danyial/makera-jog-wheel/HARDWARE_CHECKLIST.md

# Hardware checklist

Only the human ticks items here. Firmware development checks none of this by itself.

## Hardware checks

- [ ] H-1: Confirm the mapping "silkscreen label → GPIO" for all pins from SPEC 7.3 with the diagnostics screen (10.3), before soldering.
- [ ] H-2: Check whether the axis buttons are normally open (both green wires). If normally closed, switch `BUTTON_ACTIVE_LOW` in `core_config.h` and increase the pull-ups on X and Y to 100 kΩ.
- [ ] H-3: Run one button LED directly from 3V3, measure the current and judge the brightness. Up to 12 mA directly on the GPIO; above that AO3401 high-side and `LED_ACTIVE_HIGH = false`. Too dim: `LED_DUTY_PERCENT = 100`.
- [ ] H-4: In the diagnostics screen, exactly one revolution clockwise: counter +400, one detent = 4 counts. Otherwise adjust `COUNTS_PER_DETENT` or `ENC_INVERT` and record it in `DECISIONS.md`. Additionally turn briskly: no lost detents at 3.3 V (otherwise fallback 5 V + BSS138, SPEC 7.2).
- [ ] H-5: Measure the quiescent current after battery shutdown, target under 1 mA.
- [ ] H-6: Confirm the battery divider 1 MΩ/1 MΩ on GPIO34 on the FireBeetle 2 ESP32-UE (diagnostics screen shows mV). If it is missing, add an external 1M/1M divider with 100 nF.
- [ ] H-7: On USB without a battery in J1, read the voltage in the diagnostics screen. It must lie outside 2800–4400 mV or above 3400 mV; otherwise adjust the thresholds and record them in `DECISIONS.md`.
- [ ] H-8: Read the wheel's current at 3.3 V on the bench supply and enter it in `WIRING.md`. Switch the handwheel on ten times at about 3.5 V battery voltage: no reset. Otherwise soft start at the gate (10 kΩ in series, 100 nF gate–source).
- [ ] H-9: On USB with the on/off button off the board sleeps (display dark, no Wi-Fi), with the button on it runs; with the button off the battery charges (record in `WIRING.md`, details H-23 a, b).
- [ ] H-10: Rotary axis A (ticket #14) with the rotary module connected: (a) The status report contains the 4th value in degrees (serial or display). (b) In inch mode (`G20`) the A value stays in degrees, display unchanged. (c) Capture the status report **without** the module (does it still have 5 values?) and check via MDI in Studio what a small `$J A0.010 F0.500` does without the module; result in `DECISIONS.md`. Until then, enable axis A only with the module connected. (d) Confirm pins GPIO36 (A0, button A) and GPIO4 (D12, LED A) in the diagnostics screen (like H-1).
- [ ] H-11: Carrier board (ticket #20) before milling: check the row spacing of the FireBeetle pin headers on the printout (22.50 mm according to DFRobot footprint DFR0654; if different, change `ROW` in `hardware/generate_board.py` and run `hardware/export.sh`). Print `fab/handrad-1to1.pdf` at 100 %, lay the FireBeetle with its socket headers and JST-XH on it: the holes must match. Before inserting the FireBeetle, use the continuity tester on the FireBeetle itself to check that pin 2 of the top row (3V3) and pin 2 of the bottom row (silkscreen RST/3V3/NC/GND: 3V3) are connected. If the bottom pin 2 is VCC/5 V, do not use the board: 5 V would reach GPIO23/19 via the encoder pull-ups. Since ticket #25 the board is in landscape format: the USB-C socket must protrude 1 mm beyond the left edge. Pogo pins P1/P2 (pitch 3.81 mm): check their position on the printout against the pads "Li-ion −/+" on the FireBeetle underside, measure the gap carrier board ↔ FireBeetle underside; solder in P50-J1 with the head at gap + 1.3 mm above the board (jig). After assembly, check with the multimeter: no connection 3V3–GND and BAT+–BAT−; P2 has contact to "Li-ion +", P1 to "Li-ion −"; the PH2.0 socket on the FireBeetle stays empty.
- [ ] H-12: Web UI (ticket #17) in normal operation, machine online: (a) Status page reachable at `http://handrad.local/` and at the IP reported over serial (`Web: http://…`); values (connection, RSSI, state, WPos/MPos, lock reason, axis, battery, statistics) update about every second and match the display. (b) Save `/settings` without or with a wrong handwheel password: rejected ("Handrad-Passwort falsch" (handwheel password wrong)), nothing changed, no restart; a second attempt within 2 s reports "Zu viele Versuche" (too many attempts). (c) Select axis X, then save with the correct password: rejected with 409 ("Nicht gespeichert: Eine Achse ist gewählt …" (not saved: an axis is selected …)), nothing changed, no restart. Likewise while turning (session active). (d) No axis selected, correct password, e.g. port unchanged and toggle "Drehachse A" (rotary axis A): "Gespeichert" (saved), restart, the change is active. (e) While the status page is open, the machine never moves without turning the wheel.
- [ ] H-13: Loop duration before/after (ticket #17): With the state before #17 (`main` before the merge) and with #17, jog online for 1 min each and note the serial statistics lines (`max. Loop`, `Loop Mittel` (loop average), from #17 also `max. Web`); with #17 once without and once with the status page open in the browser. Expectation: `max. Web` under 5000 µs, `max. Loop` with the status page open at most about 5 ms above the value without, no additional `Keine Daten` (no data) stalls. Result in `DECISIONS.md`.
- [ ] H-14: Screensaver (ticket #28) in normal operation, machine online, no axis selected, serial monitor running: (a) 60 s without button and wheel: the screensaver image appears (serial `Anzeige: Bildschirmschoner` (display: screensaver)) and jumps to a new spot about every 5 s, otherwise the screen is black; the image is recognisable (with `src/logo_bitmap.h`, i.e. the private repository, the Makera "M", without it (public export) the lettering "MPG", tickets #45, #50). (b) 10 min without input: display fully off (`Anzeige: aus` (display: off)). (c) In the screensaver and in the off state, press X once each: the display shows the main screen, **no** axis selected (LED X stays off, `Anzeige: geweckt, Eingabe verworfen` (display: woken, input discarded), no line `Achse: X` (axis: X)). Waking with X and Y almost simultaneously: likewise no axis. A second press on X (later than 0.15 s after waking) selects X. (d) In the screensaver and in the off state, turn the wheel one detent and briskly several detents: the display wakes up, the machine does not move; then select X and turn one detent: exactly one step, no catch-up travel from the wake-up turn. (e) Select axis X and do not operate for 60 s: only when LED X goes out (auto-deselect) does the screensaver start, never with an axis selected. (f) In the screensaver, disconnect the machine's Wi-Fi or switch the machine off: the display wakes up and shows `WLAN…` (Wi-Fi…)/`Maschine…` (machine…) without a button press. In the screensaver, trigger an alarm on the machine (e.g. limit switch by hand): the display wakes up. Only lightly nudge the wheel in the screensaver, without a detent: the screensaver usually stays; half a detent wakes it. (g) Without a display connected (serial only) everything runs as before, the `Anzeige:` lines appear. (h) After a few hours of operation with the screensaver, no visible burn-in of the main screen.
- [ ] H-15: Enclosure (ticket #30), test print: (a) Axis buttons M12, latching on/off button M12 (right wall) and handwheel (cutout Ø 43, 3 × M3 studs, pot 6.4 deep; seating surface flat after removing the supports) fit without rework, button heads sit in their 1 mm pockets, the handwheel flange sits just below the front, the handwheel strands can be bent behind the body and routed along the intended path (up in front of the battery, over the battery between Y and Z) to J6; the buttons' nuts can be tightened next to each other. (b) Display: glass rests against the window, visible area complete, module sits on the 4 pins without pressure on the glass. (c) With the enclosure closed, plug the USB-C cable fully into the FireBeetle's socket: charging and serial work. (d) Lip/rebate close without gaps, 4 × M3 × 10 engage in the heat-set inserts. (e) PCB adhesive antenna 50 × 15 (ticket #44) in the recess on the top end wall, excess cable as a loop in front of the FireBeetle, does not get pinched when closing: measure RSSI (web UI or serial) at the same spot once with the board open (antenna free) and once in the closed enclosure, record the difference and values in `DECISIONS.md`. Connection in the closed enclosure stable at the usual location (no `WLAN…` interruptions over 10 min). (f) Insert the battery with hook-and-loop tape, the tray lies flat.
- [ ] H-16: Feed from turning speed and bundling (ticket #32), machine online, axis X, serial monitor running: (a) Turn slowly detent by detent: exactly 0.01 mm per detent, immediate response, no motion without turning. (b) Turn evenly at medium speed (about 1 revolution in 2 s): the machine moves evenly, `Begrenzt` (limited) does not appear or only very briefly. (c) Turn evenly fast (about 2 revolutions per second): no more heavy stop-and-go as before #32; note the impression (smooth / slight jerking / heavy). (d) Measure the overrun after letting go with a stopwatch or the position display. Expectation (SPEC 8.7): distance about `0.08 × turned distance + 0.11 s × speed`, at most 5 mm; time about `0.09 × turning duration + 0.2 s`. Examples: 2 s medium (about 5 mm/s) → about 1.6 mm in 0.4 s; 10 s slow (about 1 mm/s) → about 1 mm in 1.1 s; long fast → 5 mm in about 0.3 s. Never more than 5 mm. (e) The same with XY (diagonal, same feel as X) and Z (overrun at most 1 mm, Z never faster than 5 mm/s). (f) With axis A and rotary module (if available), turn at medium speed: no error, overrun at most 2°; A may still stutter somewhat (the firmware accelerates A itself). (g) Turn quickly back and forth: after letting go, no overrun beyond the window. (h) Turn slow-to-medium for 30 s without pause, then let go: no error message, no position error (end position = display), overrun at most 5 mm (upper limit of the queue). (i) A/B comparison: flash (b), (c) and (d) once with `FEED_LEAD_PCT = 92` (state of the ticket) and once with `FEED_LEAD_PCT = 130` in `core_config.h` and compare (jerking, `Begrenzt`, overrun). Result (in particular (c), (d) and (i)) in `DECISIONS.md`; adjustments of `FEED_LEAD_PCT`, `FEED_WINDOW_MS` or `BUNDLE_MS` as a separate ticket. **Addendum ticket #38:** Until now `F` ran with wrong machine rates (X/Y 2.5 times, Z 1.67 times too fast), so the machine moved faster than turned. Results of (a)–(i) before #38 are not valid; after #38 (rates via `M203.1`, H-20) **re-check everything**, in particular (c) stop-and-go, (d) overrun and (e) Z never faster than 5 mm/s.
- [ ] H-17: OTA update over Wi-Fi (ticket #35), handwheel in normal operation, machine online, serial monitor running (or USB disconnected, then display only): (a) By default or after the first flash of this firmware, "Update über WLAN erlauben" (allow update over Wi-Fi) is off in the portal and under `/settings`; `HANDRAD_OTA_PASS=<Handrad-Passwort> pio run -e firebeetle-ota -t upload` fails (no response), no `OTA:` line on serial. (b) Enable the checkbox, save, restart; serial `OTA: erlaubt, espota an handrad.local Port 3232 …` (OTA: allowed, espota to handrad.local port 3232 …). The status page and `handrad.local` keep working fine (mDNS not disturbed). (c) No axis selected: upload with wrong password → espota reports "Authentication Failed" (the automatic MD5 second attempt gets no response because of the lockout), serial once `OTA: abgelehnt (Passwort falsch)` (OTA: rejected (password wrong)) and `OTA: nach falschem Passwort 5000 ms gesperrt` (OTA: locked for 5000 ms after wrong password); a new upload within 5 s gets no response, afterwards it does again, no restart, the connection to the machine remains (note the duration of the check from `OTA: handle() dauerte … ms` (OTA: handle() took … ms); above about 2500 ms → `Keine Daten`/connection teardown possible, then result in `DECISIONS.md`). (d) With the correct password: display "Update" with a rising percentage, serial `OTA: Update startet …` (OTA: update starting …) and `OTA: … %`, then "Fertig, Neustart" (done, restarting), the new firmware runs (e.g. start screen, uptime on the status page reset), Studio and Home Assistant stay connected. Also from the screensaver or with the display switched off: the display turns on for the update. (e) Select axis X (LED on), then start the upload: espota aborts without a response ("No response from the ESP"), the handwheel stays in operation, X stays selected, **the machine does not move**. Likewise while turning. Then deselect X: the upload works on the next attempt. (f) Start the upload and at about 50 % disconnect the computer's Wi-Fi or abort espota with Ctrl-C: after at most a few seconds "Fehlgeschlagen" (failed), restart, the **old** firmware runs (check version/uptime), the connection to the machine comes back. (g) Never any machine motion during an upload; after the restart no axis is selected.
- [ ] H-18: New web UI (ticket #36) on the device, machine online, phone (portrait and landscape) and desktop browser, light and dark: (a) Status page, `/settings` and the captive portal look the same and load without internet (airplane mode with only the handwheel/workshop Wi-Fi); all fields in the portal and under `/settings` incl. "Update über WLAN erlauben" and "Handrad-Passwort" (handwheel password) save as before. (b) State, lock reason, WPos/MPos and battery match the display; when jogging with the wheel the crosshair glides without jumps, the numbers show the real value, the selected axis is highlighted. (c) Switch the handwheel off: after about 3 s, "Keine Verbindung zum Handrad" (no connection to the handwheel) appears in red at the top. (d) **Check the spoilboard position** (measured in ticket #40, corner −206.580/−209.140 mm MPos): use the handwheel to move the tool exactly over the centre of one hole at the back right and one at the front left (30.0/7.5 mm from the front left corner); the map's crosshair sits centred on the hole in each case, below the map there is no notice "Plattenlage geschätzt" (spoilboard position estimated). If there is a deviation, note MPos X/Y of the hole and report it (if only one is off, the spoilboard is rotated/mirrored). (e) Repeat H-12 and H-13 (loop duration, `max. Web`) with the new status page open and note the results. (f) Weak Wi-Fi: phone or laptop at the farthest point of the workshop (handwheel RSSI about −80 dBm, shown on the status page under connection → Wi-Fi), reload the status page several times: it loads completely every time (position map and numbers present), and the serial log shows no `Web: Anfrage verworfen (Zeitlimit beim Senden …)` (web: request discarded (timeout while sending …)) (the roughly 12 KB must go out within `WEB_REQ_TIMEOUT_MS = 2000`).
- [ ] H-19: 3D view (ticket #37) on the device, machine online, serial monitor running: (a) Open the status page on the phone (workshop Wi-Fi, without internet) and on the desktop: it appears immediately in 2D as before. Tap "3D": time until the image appears (first load, about 178 KB) and note it; on the second opening 3D comes from the browser cache (almost immediately). Meanwhile the status polling keeps running (no red bar "Keine Verbindung" (no connection) for longer than briefly). (b) Loop duration as in H-13: note the serial statistics line (`max. Loop`, `Loop Mittel`, `max. Web`) once without a browser and once during the first load of the 3D view (clear the browser cache beforehand, two devices at the same time); expectation `max. Web` under 5000 µs, no additional `Keine Daten` stalls, no `Zeitlimit beim Senden` (timeout while sending) on serial. With an axis selected and the wheel turned: the machine moves as it does without a browser. (c) In 3D: rotate, zoom, pan with finger and mouse; "Ansicht zurücksetzen" (reset view); when jogging with the wheel the tool glides without jumps, position and work zero match the 2D map, the travel trail shows the path. Toggle light/dark. Reload the page: 3D stays selected. (d) With the rotary axis module connected and "Drehachse A vorhanden" (rotary axis A present): the module appears, the stock rotates with A, the angle matches the display; the position of the module is checked in H-22 (ticket #48). (e) After an OTA update (H-17) with a changed 3D view, the new version arrives (new path `/a/v3d-…`) without clearing the cache. Result (load time, loop values) in `DECISIONS.md`. (f) Ticket #39, rotary axis module connected or not: in the settings, "Drehachse A vorhanden" off: the status page shows no line A under position, no A disc in 2D, in 3D neither module nor angle chip nor the "A-Modul" (A module) switch (even if the machine reports an A value). Switch on and save: everything appears again, the chip shows the work angle large and the machine angle small, matching line A. (g) With rotary axis: switch "A-Modul" off → the module disappears, the chip remains; reload the page → stays off; on again → module is there. On the desktop (from 900 px) the position map is wider than the right column, the right cards stack without gaps.
- [ ] H-20: Maximum rates at runtime (ticket #38), machine online, serial monitor running: (a) After switching on, shortly after `Link: Online` exactly one line `Raten: X 50.000 Y 50.000 Z 16.667 mm/s, A 30.000 Grad/s (M203.1)` (rates: … degrees/s) appears (the machine's values; on the user's Z1 Pro `M203.1` reports A = 30 °/s, A possibly `unbekannt` (unknown)); if instead `Raten: Antwort verworfen: …` (rates: answer discarded: …) appears, note the line and record it in `DECISIONS.md` (parser ticket, do not bypass the lock). (b) Select axis X immediately after switching on and turn: until the rates are in, display and web UI show `Raten unbekannt` (rates unknown), the machine does not move; then `Bereit` (ready), jogging works. (c) Watch the console in Studio: the answer to `M203.1` and `ok` appear there once per connect, Studio stays connected and works normally. (d) Switch on with the machine in alarm (e.g. emergency stop pressed): display `Alarm` with the real alarm line (never `error:Alarm lock`), on serial **no** `Raten:` line and no `Maschine meldet: error:Alarm lock` (machine reports: error:Alarm lock) as long as the alarm persists; after acknowledging the alarm immediately (under 1 s) `Raten: …` and jogging possible. (e) Without an answer (e.g. machine busy during connecting): the connection stays up (no teardown because of the query), serial retries after 1 s, 2 s, 5 s, 5 s. (f) Switch the handwheel off and on, or briefly disconnect the machine's Wi-Fi: the rates are re-read on every connect (new `Raten:` line). (f2) Re-read: handwheel connected, no axis selected, machine Idle; watch the console in Studio: about every 30 s an `M203.1` answer with `ok`, Studio works normally; none during a handwheel session (turning) or in alarm. Machine settings are not changed for this; that a changed rate is adopted and that a failed re-read keeps the old rates is checked only by test 99. (g) Then H-16 completely again, with axis X: (c) fast turning without heavy stop-and-go, Z never faster than 5 mm/s, X/Y never faster than 20 mm/s.
- [ ] H-21: Unlock after alarm (ticket #41, SPEC 8.10), machine online, Studio connected, serial monitor running: (a) Put the machine into alarm (halt in Studio/`Ctrl-X`), no axis selected on the handwheel: the display immediately, or after an alarm line that may be shown (2 s), shows `Entsperren: Taste 5 s` (unlock: hold button 5 s) (outside Grbl mode `Ctrl-X` only reports `HALTED, M999 or $X to exit HALT state`, no alarm line), the web UI shows `Alarm, Taste 5 s: Entsperren` (alarm, button 5 s: unlock) in red. (b) Press X and release after about 3 s: the bar runs, serial `Entsperren: abgebrochen (losgelassen)` (unlock: aborted (released)), the machine stays in alarm. (c) Hold X for 5 s: bar full, `Entsperren...` (unlocking...), serial `Entsperren: $X gesendet` (unlock: $X sent), Studio shows `[Caution: Unlocked]`, the machine reports `Idle`; nothing moves, not even after 10 s. (d) In alarm and while holding, turn the wheel vigorously, then unlock: the machine does not move afterwards; only new turning moves it (X is selected). (e) Press the button already before the alarm and keep holding: no unlock; only releasing and a new 5 s hold unlocks. (f) Alarm with the display asleep (screensaver): the display wakes up by itself, after that the first press counts. If it falls asleep again during the persisting alarm, the first press only wakes it (serial `Anzeige: geweckt, Eingabe verworfen`), holding does not unlock; only a new press does. (g) After `$X`, compare the reported position with Studio (equal); the rates remain known. (h) Limit switch alarm (carefully drive slowly into a limit switch): unlock works the same way, moving away from the limit switch works, moving further into it triggers alarm again. (i) With Studio connected, observe whether the notice stays visible: if the Wi-Fi module mirrors error lines of other clients (`error…`), they displace it for 2 s and abort a running hold (serial `Entsperren: abgebrochen (neue Meldung)` (unlock: aborted (new message))); note how often that happens. (j) Each of the buttons X, Y and Z triggers individually (bit mapping). With `axis_a` disabled, hold button A for 5 s → no unlock; with `axis_a` enabled, A unlocks too. (k) Short Wi-Fi hiccups while holding (e.g. handwheel further away from the AP) do not abort (no `Entsperren: abgebrochen` on serial); sending happens with the next fresh status.
- [ ] H-22: Position of the rotary axis module from CAD (ticket #48, SPEC 9.1, DECISIONS.md 2026-11-11), Makera rotary module mounted as intended by Makera, "Drehachse A vorhanden" on, machine online, 3D view open. Jog carefully with the handwheel (slow, no stock in the chuck or a known round stock), never touch the module with a running spindle. Note MPos values and report them: (a) **Axis Y:** bring the tool tip (pointed tool or probe pin) to the centre of the live centre tip of the tailstock (or by eye exactly above the axis on a clamped round stock) and read MPos Y. Expected from CAD: **−115.88 mm**; anchor 1 + `rotation_offset_y` of the machine config would give −125.14 mm. Which one fits (± 1 mm)? (b) **Axis height:** measure from the spoilboard top to the axis (e.g. caliper to the live centre tip): expected **45.0 mm**. (c) **X:** touch the front face of the chuck body (Ø 48.7 mm, behind the jaws) from the right with the side of the tool: expected tool centre MPos X ≈ **−163.34 mm plus the tool radius**; the front faces of the jaws ≈ −149.44 mm, the headstock block (front face −196.34 mm) is hidden behind the chuck. The tailstock can slide on the rail: in CAD its live centre tip is at −16.15 mm, the view always draws it there. (d) In the 3D view the module sits where it sits on the machine (headstock left, motor housing in front of the axis, tailstock right), the stock rotates with A in the same direction as on the machine, the chip shows "Lage der Drehachse aus CAD". `UI_A_POS_CALIBRATED` is only set to true in a follow-up ticket once (a)–(c) fit or are corrected.
- [ ] H-23: Soft power (ticket #49, SPEC 9.3), serial monitor running where possible: (0) Boot line shows `Platine Rev. 2`, the diagnostics screen `Platine 2`; confirm the rev-2 pin map in the diagnostics screen like H-1: buttons X GPIO13, Y GPIO26, Z GPIO35, A GPIO36, LEDs X GPIO14, Y GPIO25, Z GPIO15, A GPIO12, on/off GPIO4; the board boots normally with all LEDs connected (GPIO12/15 are strapping pins). (a) Button off, USB unplugged: current from the battery (multimeter in series at J1) **below 1 mA**; note the value in `WIRING.md`. (b) Button off, USB plugged in, battery not full (record in `WIRING.md`): the FireBeetle's charge LED is on and the battery reaches about 4.2 V (charge LED off), the handwheel stays asleep (display dark). (c) Switch on: the handwheel wakes and starts normally (start screen, Wi-Fi, no axis selected), also on battery only; X held while switching on → portal. (d) Flash over USB with the button off: after the upload the serial monitor shows `Ein/Aus: aus beim Start, Tiefschlaf` and the display stays dark; switching on starts the new firmware. (e) Machine online, select X and turn: switch off during the motion → serial `Ein/Aus: aus, Tiefschlaf`, the motion ends within the window (at most 5 mm), Studio shows no further `$J` from the handwheel, Studio and Home Assistant stay connected; switch on → reconnects, nothing moves until turned again. (f) Battery shutdown (bench supply below 3.3 V) with the button on: "Akku leer – bitte ausschalten", then dark; the handwheel does not restart by itself; button off and on with the supply still low → "Akku leer" again; supply at 3.8 V → off and on starts normally.
  (h) Board revision guard: erase the flash (`pio run -t erase`), flash, serial `Platine Rev. 2 gespeichert` once; the next start without that line.

## Acceptance on the machine (SPEC ch. 13)

- [ ] A-1: Job running in Studio: the handwheel shows `Job läuft` (job running), turning moves nothing.
- [ ] A-2: X alone, XY diagonal and Z alone move in the positive direction when turned clockwise. A press on Z with X selected deselects X and selects Z (the LEDs show it).
- [ ] A-3: 60 s without turning: all axis LEDs go out, turning moves nothing.
- [ ] A-4: Turn the wheel fast for 1 s and let go: the machine stops after at most 5 mm (XY) or 1 mm (Z) overrun (window since ticket #32).
- [ ] A-5: Turn quickly back and forth: after letting go, no overrun beyond the window.
- [ ] A-6: Studio and Home Assistant stay connected while the handwheel is used.
- [ ] A-7: On/off button off while moving (with and without USB): the motion ends within the window, afterwards the machine receives no more commands, the handwheel sleeps (H-23 e).
- [ ] A-8: Switch the handwheel off and on three times within 1 min, each time until "Online": Studio and Home Assistant stay connected, the handwheel reconnects each time. Result in `WIRING.md`.
- [ ] A-9: X held at power-on → web UI. "Diagnose starten" (start diagnostics) → diagnostics screen. Y or Z held at power-on → no axis selected.
- [ ] A-10: Let the battery contact J1 bounce briefly (loose contact) with a full battery: no shutdown. Tap the on/off button contact for under 0.1 s: no sleep.
- [ ] A-11: Battery shutdown (bench supply instead of battery, slowly below 3.3 V): display "Akku leer – bitte ausschalten" (battery empty – please switch off), afterwards quiescent current < 1 mA (H-5).
- [ ] A-12: Battery operation without USB, wheel at 3.3 V: one revolution turned briskly yields exactly 100 detents, even at about 3.5 V battery voltage.
- [ ] A-13: Spindle running: the handwheel shows `Maschine belegt` (machine busy).
- [ ] A-14: Axis A enabled in the portal, rotary module connected: button A deselects and selects A, turning clockwise rotates A in the positive direction, overrun at most 2°. Axis A disabled: button A has no effect, LED A off.
- [ ] A-15: Web UI (ticket #17): status page reachable, saving only with the handwheel password and only with no axis selected, saving restarts and applies the values (H-12).
- [ ] A-16: Screensaver (ticket #28): screensaver after 60 s, display off after 10 min, waking via button or wheel selects no axis and does not move (not even with two buttons), connection loss and alarm wake it (H-14).
- [ ] A-17: Feed (ticket #32): turn evenly at medium and fast speed, the machine moves without heavy stop-and-go, `Begrenzt` does not appear at medium speed (H-16, after ticket #38 with rates read, H-20).
- [ ] A-18: OTA (ticket #35): off by default; when enabled, the update over Wi-Fi works, with an axis selected it is rejected and the machine never moves; an abort in the middle of the upload leaves the old firmware running (H-17).
- [ ] A-19: 3D view (ticket #37): loads on phone and desktop without internet, the status page stays usable meanwhile, the loop duration does not rise above the H-13 level while loading, an OTA update brings the new 3D view along (H-19). Without "Drehachse A vorhanden" the page shows A nowhere; with rotary axis the A module can be hidden and the choice persists after reloading (H-19 f, g, ticket #39).
- [ ] A-20: Unlock (ticket #41): in alarm the display shows `Entsperren: Taste 5 s`; holding 4 s does not unlock, holding 5 s sends one `$X`, the machine becomes `Idle`, nothing moves by itself, detents turned during the alarm are not caught up (H-21).
