danyial/makera-jog-wheel/DECISIONS.md

# Decisions

Format: Date · Question · Decision · Rationale. Append new entries at the bottom.

## 2026-11-09 · Residual risk: job start between two status reports (SPEC 8.5)

- **Question:** Can a `$J` end up in a just-started job despite the jog gate?
- **Decision:** Yes, the residual risk remains and is accepted. If Makera Studio starts a job in the roughly 100–250 ms between two status reports, one more `$J` can still go out before `P:` is visible in the status.
- **Rationale:** The machine does not acknowledge `$J` and checks no state. Shorter than `SEND_MAX_AGE_MS = 250` ms is not sensible with polling every 100 ms. At most one window (`WINDOW_UM`) can be affected. Also in `WIRING.md` under "Safety".

## 2026-11-09 · New session on stale Idle during Wi-Fi dropouts (SPEC 8.7 c.3)

- **Question:** Is `START_GAP_MS = 200` enough as the gap between session end and status for a restart?
- **Decision:** Yes, with a documented residual risk: with round-trip times above 200 ms, a new session can start on a stale Idle; the overrun is then, in the worst case, about `2 × WINDOW_UM`.
- **Rationale:** A larger gap makes the handwheel noticeably sluggish after every session end. Also in `WIRING.md` under "Safety".

## 2026-11-09 · Foreign commands during a session (SPEC 8.7)

- **Question:** What happens if another client moves or pauses the machine during a handwheel session?
- **Decision:** Residual risk accepted: small foreign movements (deviation below `FOREIGN_TOL_UM = 100` µm) can cause handwheel steps of at most `WINDOW_UM` to be queued behind them. After a hold and resume by another client, queued handwheel steps continue for at most `WINDOW_UM`.
- **Rationale:** Larger foreign movements make the session inconsistent and end it. A tighter tolerance would treat normal measurement deviations as foreign. Also in `WIRING.md` under "Safety".

## 2026-11-09 · Auto-deselect also in `AxisSelector::on_activity` (SPEC 8.2, 8.4)

- **Question:** 8.2 explicitly requires auto-deselect only for `on_press` and `mode()`. Should `on_activity` apply it first as well?
- **Decision:** Yes. `on_activity` first applies auto-deselect and then refreshes the timestamp.
- **Rationale:** Otherwise a rotation after a pause of more than 60 s could revive a forgotten selection if `mode()` was not called in between. Safety over comfort. In normal operation `main.cpp` calls `mode()` beforehand in every tick, so the behavior there is identical.

## 2026-11-09 · Battery divider on the FireBeetle 2 ESP32-UE (SPEC 9.3, H-6)

- **Question:** Does the UE variant have the 1 MΩ/1 MΩ divider on GPIO34 (A2)?
- **Decision:** Yes, factor ×2 stays. H-6 stays open until the diagnostics screen confirms the voltage.
- **Rationale:** User measurement on 2026-11-09: 4.05 V at the battery connector, 1.933 V between A2 and GND. A multimeter with 10 MΩ input resistance in parallel with the lower 1 MΩ gives 4.05 V × 0.909/1.909 ≈ 1.93 V. This matches an unloaded 1:2 divider exactly.

## 2026-11-09 · Button "held" at power-on (SPEC 9.2 step 2)

- **Question:** When does a button count as held at startup?
- **Decision:** Only if it reads as pressed during the entire `BOOT_DEBOUNCE_MS` window.
- **Rationale:** A short glitch (GPIO36/39 errata) must neither trigger the portal nor initialize debouncing incorrectly.

## 2026-11-09 · Empty password field in the portal (SPEC 9.1)

- **Question:** What happens if the Wi-Fi password field is left empty on save?
- **Decision:** If the SSID is unchanged, the stored password is kept. With a new SSID, an empty password is stored (open network).
- **Rationale:** For security reasons the form does not display the stored password. Otherwise it would have to be re-entered on every change of the machine IP.

## 2026-11-09 · Battery measurement already in step 7 (SPEC 12)

- **Question:** Shutdown only comes in step 10. Is the measurement needed earlier?
- **Decision:** `power::measure_battery_mv()` and the 5 s measurement come with step 7 already, shutdown (`Shutdown`) only with step 10.
- **Rationale:** The diagnostics screen is to show the battery voltage for H-6 and H-7.

## 2026-11-09 · Ellipsis in status texts (SPEC 10.1)

- **Question:** The font `u8g2_font_6x10_tf` does not contain "…" (U+2026). How are `WLAN…` (Wi-Fi…) and `Maschine…` (machine…) displayed?
- **Decision:** As `WLAN...` and `Maschine...` with three dots.
- **Rationale:** Same meaning, without a larger font just for one character. The font covers the umlauts in the remaining texts (Latin-1).

## 2026-11-09 · Delivery of buffered commands after connection teardown (SPEC 8.8)

- **Question:** `lwip_close()` closes gracefully. Frames still in lwIP's send queue at teardown continue to be transmitted and can reach the machine after teardown. Can this be prevented?
- **Decision:** No, not with built-in means. The residual risk is accepted and documented.
- **Rationale:** A hard abort (RST) would need `SO_LINGER {1, 0}`. `CONFIG_LWIP_SO_LINGER` is off in the precompiled Arduino-ESP32 3.3 build, however, and a custom sdkconfig would contradict ch. 4. The risk is bounded nonetheless: at most one window (`WINDOW_UM`) is in the queue, because the planner never leaves more open relative to the reported position. If a new session starts after reconnecting before the old frames arrive, the machine travels about `2 × WINDOW_UM` in the worst case. That is the same maximum as for the residual risk "stale Idle" (8.7 c.3). Also in `WIRING.md` under "Safety".
## 2026-11-09 · Flash size in the bootloader header (ticket #16)

- **Question:** On real hardware the bootloader aborts: `partition 2 invalid - offset 0x10000 size 0x640000 exceeds flash chip size 0x400000`. Why?
- **Decision:** `platformio.ini` additionally sets `board_upload.flash_size = 16MB` and `board_upload.maximum_size = 16777216`. SPEC 6.2 is corrected accordingly.
- **Rationale:** The board profile `esp32dev` specifies `upload.flash_size = 4MB`. `board_build.flash_size` does not change the bootloader header. The build in 6.3 succeeded because the error only occurs at boot.

## 2026-11-09 · Optional rotary axis A (ticket #14, user request)

- **Question:** How is the fourth axis requested later by the user implemented? SPEC ch. 14 previously excluded the A axis.
- **Decision (user):** Rotary axis A (Makera rotary module) with its own 4th button including LED ring.
- **Decision (implementation):**
  - Pins (superseded by ticket #21, see below): button A on GPIO35 (A3, input only, external 10 kΩ pull-up), LED A on GPIO18 (SCK). The only remaining free, non-critical pins on the header (16/17 are used by the PSRAM of the R2 variant, 0/2/5/12/15 are strapping pins).
  - Internal unit millidegrees in `mpos_um[3]`/`wpos_um[3]`, so that planner, window and `format_um` still compute in integers unchanged. The A value is never converted with the inch factor (rotary axis; H-10 checks this).
  - Step sizes as for X/Y/Z (0.01°/0.05°/0.1° per detent), window 2000 mdeg = 2°, `F_SCALE_A = "0.500"`.
  - A is exclusive like Z. Optional via the portal checkbox (NVS key `axis_a`, default off). Without activation, `main.cpp` never calls `on_press` for button A.
  - New gate rule 5a: `axis == A` without a 4th value in the status → `NoAxisA` ("Keine A-Achse" (no A axis)).
  - A counts for `session_consistent` and ARRIVE only if the status reports A.
  - The real Z1 always reports 5 values, even without the rotary module (review). The firmware therefore cannot detect whether the module is connected. The portal checkbox is authoritative; rule 5a only protects against incomplete reports. H-10 (c) clarifies what `$J A…` does without the module; until then enable A only with the module.
- **Rationale:** Safety over comfort. With the same step sizes and a window of 2°, the overrun at the workpiece circumference (≈ 2 mm at 57 mm radius) stays in the order of X/Y. Turning quickly through large angles is therefore slow; this is intended. Coarser steps for A would be a later, separate decision.

## 2026-11-09 · Portal credentials on the serial console (ticket #15)

- **Question:** How does one reach the portal if no display is connected?
- **Decision:** In portal mode the firmware additionally outputs SSID, AP password, `http://192.168.4.1` and the reason for the portal (X held, board button, no credentials) over serial (115200 baud). In diagnostics mode all values of the diagnostics screen are also output serially once per second. In normal operation, changes of connection state (with failure reason), lock reason and axis selection as well as alarm lines are logged serially, only on change. Additionally, while online, a statistics line comes every 5 s (status reports, largest gap, loop and display duration). Serial gets a TX buffer of 1024 bytes so that log lines do not block the loop.
- **Rationale:** Anyone who can read the serial output has physical USB access to the device anyway. The password only protects against third parties within radio range.

## 2026-11-09 · Wi-Fi modem sleep off in normal operation (ticket #18)

- **Question:** On the real Z1, status reports arrived with gaps of 280–350 ms, the gate briefly jumped to `NoData`. Is the ESP the cause?
- **Decision:** `WiFi.setSleep(false)` in normal operation. `SEND_MAX_AGE_MS` stays 250 ms.
- **Rationale:** Modem sleep buffers incoming packets until the next beacon. Without it, latency dropped measurably, but the gaps did not disappear entirely (up to ~430 ms at max. 27 ms loop duration). The remainder lies outside the ESP (Wi-Fi or the machine's Wi-Fi module) and is handled with ticket #19. Extra consumption: about 80–100 mA in online operation.

## 2026-11-09 · Hold session on short data loss (ticket #19, user decision)

- **Question:** Remaining gaps between status reports (280–430 ms, outside the ESP) briefly set the gate to `NoData`. Per 8.7 (a) the session ends every time, and jogging stutters every few seconds. How to work around this without weakening the jog gate?
- **Decision (user, option 3):** New step 8.7 a0: on `NoData` with an existing status, age ≤ `NODATA_HOLD_MS = 1000` and unchanged axis, a running session is only paused. No command, detents are discarded, (g) keeps running. All other lock reasons end the session as before.
- **Hardening after review (a1):** Jogging resumes only on a status received at least `START_GAP_MS` after the hold began. Delayed reports delivered in a batch with content from before the gap thus release no command. Costs at most 200 ms of additional stutter.
- **Rejected:** Raising `SEND_MAX_AGE_MS` to ~500 ms. That would have doubled the time window for an unnoticed job start.
- **Rationale:** Nothing goes out during the gap. Afterwards a fresh status (≤ 250 ms) decides via rule 8 as before: job, alarm, state Idle/Run, `session_consistent`. Window and direction lock remain, a session start on a stale status remains excluded. The overrun stays ≤ `WINDOW_UM + REVERSAL_EPS_UM`, because the planner never leaves more than the window open, even after the gap.

## 2026-11-09 · Pin assignment for the single-sided carrier board (ticket #21) (superseded by ticket #25, see below)

- **Question:** With the old assignment, button and LED of X, Y and Z were on different header sides, in an order that cannot be routed single-sided without crossings. Do we change the board (wire jumpers) or the pins?
- **Decision:** The pins. New: button X → GPIO35 (A3), button A → GPIO36 (A0), button Z → GPIO13 (D7, internal pull-up), LED X → GPIO18 (SCK), LED Y → GPIO23 (MOSI), LED Z → GPIO14 (D6), LED A → GPIO4 (D12). Unchanged: button Y (39), encoder (25/26), wheel supply (19), I2C (21/22).
- **Rationale:** The hardware is not yet built, the change costs only `pins.h`. With the new assignment the board needs no jumpers at all. All inputs without internal pull-up (35/36/39) remain on external 10 kΩ pull-ups. `leds.cpp` now determines RTC-capable LED pins at runtime (`rtc_gpio_is_valid_gpio`), so that `pins.h` remains the only pin source. GPIO14 briefly outputs PWM at boot, LED Z then flickers briefly; this is non-critical.

## 2026-11-09 · Carrier board (ticket #20)

- **Question:** What does the single-sided, millable board look like?
- **Decision (user):** FireBeetle in socket headers, cables via JST-XH, milling rules 0.4 mm / 0.4 mm, battery and switch run through the board.
- **Decision (implementation):**
  - Copper only on B.Cu. THT parts from the top, SMD at the bottom.
  - Board generated by script (`hardware/generate_board.py`) instead of by hand, so that it is reproducible and dimensions such as the row spacing remain a parameter.
  - Traces planned by hand without crossings (topology see `hardware/README.md`), autorouter rejected.
  - All pin holes 1.0 mm, so that one drill suffices.
  - No schematic. The netlist is in `WIRING.md` and `hardware/README.md`.
- **Rationale:** A single-sided board without jumpers needs a planned topology; Freerouting could not have avoided jumpers. With 12 components, a schematic would be a second source that can diverge.

## 2026-11-09 · Battery via pogo pins instead of cable (ticket #20, user request)

- **Question:** Should the battery connect to the FireBeetle via the cable J3 → PH2.0 or via pogo pins onto the "Li-ion +/−" pads on the underside?
- **Decision (user):** Pogo pins.
- **Decision (implementation):** Two THT pads P1 (−) and P2 (+, switched) under the FireBeetle. J3 is dropped, because `BAT−` and `BAT_SW` would cross on one layer with both variants. Fallback: solder a cable into P1/P2. The longitudinal position was measured by the user, the transverse one estimated from the photo; the pads are wide enough. H-11 checks both on the printout.
- **Rationale:** No cable in the enclosure. The risk of a brief contact loss under vibration (restart, brownout counter) is known and accepted. Pogo pins with sufficient travel mitigate it.

## 2026-11-09 · FireBeetle row spacing 22.50 mm (ticket #24)

- **Question:** The carrier board was calculated with 22.86 mm (0.9″) row spacing, an assumption. Is it correct?
- **Decision:** No. The official DFRobot footprint DFR0654 (SnapMagic) has ±11.25 mm, i.e. **22.50 mm**. Pin 1 is 11.32 mm below the USB edge. The board is regenerated accordingly.
- **Rationale:** With 22.86 mm the 14 pins of the right row would have been offset by 0.36 mm, and the FireBeetle would not have fit into the sockets. The photo estimate (≈ 22.5 mm) was right, the 0.9″ assumption was not. Lesson: take dimensions from manufacturer data, do not derive them from grid pitches.

## 2026-11-09 · Implementation by subagents (user request)

- **Question:** Who implements features?
- **Decision (user):** Always a subagent. The main context plans, briefs, checks and merges.
- **Reconciliation with SPEC 15:** Ch. 15 prohibited delegating safety-relevant parts; what was meant was parallel work. New: these parts are worked on by only one subagent at a time, never several in parallel; before the merge, another fresh context checks against the SPEC section.

## 2026-11-09 · Compact carrier board in landscape format (ticket #25)

- **Question:** The board (66 × 110 mm) is too large for the enclosure. How does it become more compact without losing single-sided, jumper-free millability?
- **Decision (user):** FireBeetle rotated by 90°, USB-C to the left, 1.0 mm beyond the board edge. All connectors in two rows on the lower long side. Each pogo pin 0.5 mm further outward (spacing +1 mm, center unchanged).
- **Decision (implementation):**
  - Board 78 × 66 mm, topology in `hardware/README.md`.
  - New pin assignment so that everything lies on one layer without crossings: button X → GPIO39, button Y → GPIO35, LED X → GPIO25, LED Y → GPIO26, wheel supply → GPIO18, handwheel A → GPIO23, handwheel B → GPIO19. Unchanged: buttons A/Z, LEDs A/Z, I2C, battery ADC, board button.
  - `ENC_PWR` runs under the FireBeetle to the left around RST and reaches R6/Q1 from the left. Reason: the AO3401 sits mirrored on the copper side, where its pins follow G, S, D clockwise. With D at the bottom, the gate is on the left. If the gate signal came from the right, it would inevitably cross 3V3.
  - The lower 3V3 socket feeds only R6/Q1, as net `+3V3_ENC`. It is connected to the upper 3V3 only via the FireBeetle: the display lines lie in between, and a connection on the board would have to cross them.
  - All GND pins of the connectors are on the board's GND bus. GND from the FireBeetle comes via the upper row pin 3. GND pin 4 of the lower row remains unused.
  - `encoder.cpp` now calls `rtc_gpio_*` only for RTC-capable pins, because A/B are now on the digital GPIO23/19.
- **Rationale:** The hardware is not yet built, the pin change costs only `pins.h`. All inputs without internal pull-up (35/36/39) remain on external 10 kΩ pull-ups. The PCNT can read any GPIO. GPIO18 is high-impedance in deep sleep; the 100 kΩ gate pull-up then keeps the wheel off. The LED pins are now all RTC-capable.
- **Open (pogo spacing):** With +1 mm the pogo pins are 3.81 mm apart. The user photo (FireBeetle underside on the 1:1 printout, scale 2.54 mm) gives about 4.2 mm. The deviation of 0.39 mm is checked at H-11 on the printout. If needed, adjust `POGO_SPREAD` in `generate_board.py`.

## 2026-11-09 · Web UI in normal operation: server (ticket #17)

- **Question:** Arduino `WebServer` with `handleClient()` once per loop, or a custom server on lwIP sockets?
- **Decision:** Custom small HTTP server on non-blocking lwIP sockets (`src/webui.cpp`), two connections at once, per pass at most one `accept` and per connection one `recv` or one `send`. Request at most `WEB_REQ_MAX = 2048` bytes, connection at most `WEB_REQ_TIMEOUT_MS = 2000`. Parser and form fields are pure logic in `lib/core/http_parse` and tested natively. The captive portal stays with `WebServer`.
- **Rationale:** `WebServer::handleClient()` (Arduino-ESP32 3.3) reads header lines with a stream timeout and waits for POST data up to `HTTP_MAX_POST_WAIT = 5000` ms with `delay(1)`. A slow or malicious client on the Wi-Fi could thus stall the single loop for seconds (ch. 4, 8.8). In the portal this does not matter, nothing moves there. In normal operation, after this decision the web server can no longer push itself into the tick logic.
- **Known and accepted (review):** If the server closes a connection whose request it has not fully read (400, 413, timeout), lwIP sends an RST instead of a FIN; the browser then shows a connection error instead of the error page. The `Host` header is not checked, so DNS rebinding is possible; a foreign site can thus reach at most the open status page, saving still requires the password.

## 2026-11-09 · Protecting the settings: password field instead of HTTP Basic Auth (ticket #17)

- **Question:** How is saving the settings protected with `ap_pass`?
- **Decision:** A password field "Handrad-Passwort" (handwheel password) in the form, checked on every save (`secret_equals`, without early exit). After a failed attempt, further attempts are locked for `WEB_AUTH_LOCK_MS = 2000` (429). The form itself (`GET /settings`) shows SSID, machine IP, port and axis A without a password, never the passwords. The status page is open.
- **Rationale:** With Basic Auth the browser remembers the credentials and also sends them with forms from foreign sites (CSRF): any web page in the user's browser could then change settings and restart the handwheel. A field that is entered every time is unknown to a foreign site. The lock makes trying all 10⁸ digit sequences hopeless (> 6 years). SSID and machine IP are visible on one's own Wi-Fi anyway. Over HTTP the password travels unencrypted, as with Basic Auth; HTTPS would be disproportionate for a device on the home network. `ap_pass` instead of a separate password, because it already exists, is shown on the display (portal mode) and no new NVS key is needed (9.1).
- **Residual risk (review):** The lock applies to all clients jointly. A device on the Wi-Fi that sends a wrong password every 2 s locks the real user out permanently. This costs only comfort, not safety: settings can still be changed via the captive portal (hold X at power-on). A per-IP lock would be more complex and is not implemented.

## 2026-11-09 · Accepting the settings and restart (ticket #17)

- **Question:** When may the web UI apply settings, and how is the restart done after saving?
- **Decision:** Only with `axis == None` and no active session (`settings_change_allowed`), otherwise 409 and nothing changed. Checked after the password and immediately before saving. Saving, response and restart run in the same loop pass: response with one `send` (a few hundred bytes), close the web socket, `machine::stop()` (graceful close to the machine, no half-open connection there), wait `WEB_RESTART_FLUSH_MS = 300` ms, `esp_restart()`.
- **Port field now strict (portal and web UI):** `parse_port` accepts only digits. `"+2222"` and `"2222abc"` are now rejected; previously the portal accepted them as 2222 via `String::toInt()`. An empty field still yields 2222.
- **Rationale:** With a restart delayed over several passes, an axis could be selected in the meantime and a session started, which the restart would then abort. The 300 ms block the loop deliberately: axis and session are demonstrably off, nothing can be sent. The acceptance rule reads the `axis` value of the last tick; if auto-deselect was just running there, it rejects when in doubt (safety over comfort).

## 2026-11-09 · mDNS name `handrad.local` (ticket #17)

- **Question:** How does one find the web UI when the IP is assigned via DHCP?
- **Decision:** `ESPmDNS` from the Arduino core registers `handrad.local` and the service `_http._tcp`. Additionally, when the web UI starts, the firmware outputs `Web: http://<IP>/ bzw. http://handrad.local/` (Web: http://<IP>/ or http://handrad.local/) serially; the status page shows the IP.
- **Rationale:** `ESPmDNS`, like `WebServer` and `DNSServer`, is part of the core; it is not a third-party library (ch. 4). It responds from the IDF network task, not from our loop, and costs no loop time. Cost: about 36 KB flash and 2 KB RAM (measured). Several handwheels on the same network are out of scope (ch. 14). mDNS is not auto-discovery of the machine (9.1); it only makes the handwheel itself discoverable.

## 2026-11-09 · Content of the status page (ticket #17)

- **Question:** Which unit do the positions show, and which statistics?
- **Decision:** WPos/MPos always in mm with 3 decimal places (A in degrees), even with `inch_mode`; the inch mode appears as `inch_mode` in the JSON. The link statistics are those of the last completed 5 s window of the serial statistics line (initially `null` after a new connection). The web UI never reads the counters back itself.
- **Rationale:** `take_stats()` resets the counters; a second reader would corrupt the serial statistics. mm is the internal unit (µm); a conversion in the browser would be a second rounding rule alongside `format_inch_e4`.

## 2026-11-10 · Screensaver: timings, waking, attention (ticket #28)

- **Question:** When does the OLED go into the screensaver or off, what wakes it, and what happens to the waking input?
- **Decision:**
  - `SCREENSAVER_MS = 60000`, `DISPLAY_OFF_MS = 600000`, `SAVER_MOVE_MS = 5000` (`core_config.h`). Measured from the last input (press edge of any button, including A without activation and the board button, or `counts ≠ 0`) or from the last attention event. Only in normal operation; portal and diagnostics remain unchanged.
  - Never screensaver while an axis is selected or a session is running. This only keeps the display on; the timer keeps running from the last input: after auto-deselect (also 60 s) the screensaver starts immediately. A separate second 60 s period after deselection would gain nothing; the display then only shows "Achse wählen" (select axis).
  - Edges and `counts` are discarded (plus `accumulator.clear()`, **before** step 0 of 8.7) while the display sleeps, in the wake tick, and for `WAKE_SWALLOW_MS = 150` afterwards (review of ticket #28). Anyone waking with two buttons whose edges are a few ms apart thus deterministically achieves nothing; 150 ms is well below a deliberate second press. Because the screensaver only starts with `axis == None`, the gate locks anyway (`AxisNone`); swallowing prevents the waking press from selecting an axis. PCNT counts do not pile up: `take_counts()` runs every tick even in the screensaver.
  - The wheel wakes only from `WAKE_MIN_COUNTS = COUNTS_PER_DETENT / 2` (half a detent), summed over ticks, sum reset after `STEP_RESET_MS` without a count (review of ticket #28). A single glitch or ±1 jitter on A/B therefore does not wake, a real rotation of half a detent does. With the display on, every count still counts as input (otherwise the screensaver could kick in during very slow turning).
  - Attention (wakes without wake window, timer restarted): MachineLink leaves `Online`, `battery.warn()` becomes true, new alarm/error line (`alarm_ms()` changes), machine status becomes `Alarm` or `halted`. The status is observed directly, not the gate: in the screensaver `axis == None`, so the gate returns `AxisNone` (rule 5) and never `Alarm` (rule 7) (review of ticket #28). Not: `Job läuft` (job running)/`Maschine belegt` (machine busy) (a long job would otherwise burn in exactly the static content the screensaver guards against). `Shutdown` itself turns the display on for "Akku leer" (battery empty).
  - `Off` stays `Off` until the next input or attention, even when the idle time overflows after 49.7 days.
  - In the screensaver, redrawing happens only on a position change (one frame of about 23 ms every 5 s instead of 5 per second), in the off state not at all. Randomness: `esp_random()` (hardware RNG).
  - Serial (for operation without display, ticket #15): `Anzeige: Bildschirmschoner` (display: screensaver), `Anzeige: aus` (display: off), `Anzeige: an` (display: on), `Anzeige: geweckt, Eingabe verworfen` (display: woken, input discarded).
- **Rationale:** 60 s matches auto-deselect; after that the display is static anyway. 10 min of screensaver gives time to look at the display before it goes off completely; off saves power (battery) and OLED lifetime. Safety: the screensaver can only remove inputs, never create them. Gate, planner and window (8.5–8.7) are unchanged.

## 2026-11-10 · Makera logo in the screensaver (ticket #28)

- **Question:** May the Makera logo be in the repository, and how does it get into the image?
- **Decision:** The logo is a **trademark of Makera**. It is used only for **private use** in this private repository and must be removed or replaced by an own motif **before any publication** (repo public, distribution of the firmware). The repository contains only the generated header `src/logo_bitmap.h` (XBM, 40 × 32 px, 160 bytes), not the source (the user's PNG). **Superseded** by 2026-11-11 (ticket #45): `src/logo_bitmap.h` is git-ignored and stays local; without the file the screensaver shows a neutral "MPG". **Superseded by #50:** committed in the private repository, left out of the public export. **Superseded by #46/#50:** the public export has no Git history and does not include the logo.
- **Conversion:** `tools/logo_to_xbm.py` (Python with Pillow, development tool only, no firmware dependency): every dark or distinctly colored pixel (black and the blue stroke) becomes a lit pixel, white stays off. Cropped to the content, scaled to at most 40 × 40 preserving aspect ratio (gives 40 × 32), threshold 50 %. Invocation: `python3 -I tools/logo_to_xbm.py <logo.png> src/logo_bitmap.h [vorschau.png]`.
- **Cost:** Flash +2.7 KB, RAM +24 bytes (measured, whole ticket).

## 2026-11-10 · Web UI closed without response (ticket #29)

- **Question:** Why did curl get `Empty reply from server`, and how will something like this become visible in the future?
- **Cause:** `respond()` stamped the response with `millis()`, while the time check at the end of `webui::loop()` computes with the `now` from the start of the loop pass. If even 1 ms passed between the two (MachineLink, display, building the response), `uint32_t(now - since_ms)` overflows to about 2^32, is ≥ `WEB_REQ_TIMEOUT_MS`, and the connection is closed in the same pass before a byte is sent.
- **Decision:** All timestamps of a connection come from the pass's `now` (`pass_ms`), never from `millis()`. The check lives as `web_conn_expired()` in `lib/core` and computes with a signed difference: a stamp from the future counts as not expired (the budget is 2 s, far below 2^31 ms). Serial `Web: Anfrage verworfen (<Grund> <Zahl>)` (Web: request discarded (<reason> <number>)) for timeout while reading (with bytes > 0) and sending, `recv`/`send`/`accept` errors, peer abort in the middle of the request, and 400/413; at most one line per `WEB_LOG_MIN_MS = 5000`, suppressed lines are counted. A pre-connection without a single byte is closed silently.
- **Rationale:** One time base per pass is the root-cause fix; the robust check additionally protects against future mixing of clocks. The rate limit keeps the loop free (serial buffer 1024 bytes). Gate, planner and window (8.5–8.7) are unchanged; the web UI still sends nothing to the machine.

## 2026-11-10 · Enclosure: on/off switch in the right side wall (ticket #30)

- **Question:** In the sketch the on/off switch sits on the front. Does that work?
- **Decision:** No. It sits in the **right side wall** at y 108, z 25 (entirely in the front shell), engraving "I/O" next to it. Addendum (user): the switch is a **latching 12 mm metal push button from the same series as the axis buttons** (hole Ø 12.2, head Ø 14 in pocket Ø 15 × 1, body Ø 12 × 17), not the initially assumed 16 mm switch; SPEC 7.1 is adjusted.
- **Rationale:** On the front, the body including leads would reach down to z ≈ 12…14 and hit the battery connectors J1/J2 on the carrier board. Horizontal in the side wall it lies above the battery (z ≥ 17) and next to the buttons, clearance to everything ≥ 8 mm (collision check in `hardware/enclosure/README.md`).

## 2026-11-10 · Enclosure: split at z = 12 and heat-set inserts (ticket #30)

- **Question:** Where does the enclosure split, and how is it screwed together?
- **Decision:** Bottom tray z 0…12, front shell z 12…40, lip 1.2 × 2 of the bottom tray in a **rabbet** (step, open to the inside) of the front shell, 0.2 clearance to the outer skin and upward. A closed groove does not fit: lip 1.2 + 2 × 0.2 clearance + outer skin ≥ 1.2 gives 2.8 mm, more than the wall (2.5). 4 × M3 × 10 from below into **heat-set inserts M3** (hole Ø 4.0 × 6) in bosses Ø 8 of the front shell. The counterbore in the bottom tray is **6 mm** deep (ticket: 3 mm), in a foot Ø 10 with pillar Ø 7 and a web to the corner.
- **Rationale:** Up to z 12, the board (z 7…8.6) including holder and the battery (up to z 13) fit almost entirely into the bottom tray; everything operable (display, buttons, switch, handwheel, USB-C) sits in the front shell and can be pre-assembled. With a 3 mm counterbore the head would sit at z 3, and an M3 × 10 would reach the insert (from z 12) by only 1 mm. With the head seating at z 6, M3 × 10 engages 4 mm. Heat-set inserts withstand repeated opening; threads cut directly into plastic do not.

## 2026-11-10 · Enclosure: CAD coordinates mirrored in y (ticket #30)

- **Question:** The ticket frame (x to the right, y = 0 at the top at the display, z towards the viewer) is left-handed, like the KiCad top view. How does it get into right-handed SolidCraft?
- **Decision:** In CAD, Y_CAD = 200 − y applies. All positions stay in ticket coordinates in `make_enclosure.py` and in the README.
- **Rationale:** With unchanged numbers the result would be the mirror image: USB-C cutout on the right instead of the left, and the enclosure would not fit the board.

## 2026-11-10 · Enclosure: antenna inside, FPC adhesive antenna (ticket #30)

- **Question:** The FireBeetle 2 ESP32-UE needs an external u.FL antenna. Inside or outside (SMA rod antenna)?
- **Decision:** **Inside**: FPC adhesive antenna with u.FL (about 40 × 10 × 0.2 mm, cable ~10 cm) on the inside of the upper end wall. Free, rib-free area 50 × 15 centered at x 55, z 25, with a 0.3 mm deep positioning recess 46 × 12 in it. No hole. (Antenna, recess and position replaced by ticket #44: PCB antenna 50 × 15, recess 51 × 16, center x 46, see below.)
- **Rationale:** User request: the antenna should sit inside the enclosure. A rod antenna (100 mm and more) would stick out awkwardly from the handheld device and would need an SMA hole. The end wall is far from the metal body of the handwheel and from the battery, close to the u.FL output of the FireBeetle. Whether the range is sufficient in the closed enclosure is checked by H-15.

## 2026-11-10 · Enclosure: review and user requests on the merge request (ticket #30)

- **Display centered:** Since the switch sits in the side wall, the display is horizontally centered (`DISPLAY_CX = W/2 = 46`): module x 28.3…63.7, window x 30.8…61.2, pins at x 30.8/61.2.
- **Module dimensions SH1106 1.3″:** module 35.4 × 33.5, glass 34.4 × 23 × 1.5 (front), board 1.2 behind it, visible window 30.4 × 15.7, mounting holes Ø 3.0 at ±15.2 / y 2.5 and 31 from the pin header edge. Source: STEP model of the user's 1.3″ module (taken over via the ticket specification, the model itself is not in the repository). The pins protrude 2.2 mm behind the module board, for heat staking.
- **Pockets for button heads and handwheel:** button head Ø 14 in pocket Ø 15 × 1, handwheel front Ø 60 in pocket Ø 61 × 1, edges chamfered 0.3. Remaining plate 2 mm (M12 nut: enough thread). Under the handwheel pocket a ring on the inside (Ø 44…58 × 1.5), because there only 2 mm of plate remain between cutout Ø 42.5 and pocket edge; the ring keeps 1 mm clearance to the handwheel body Ø 42. (Replaced by ticket #31: cup instead of pocket and ring, cutout Ø 43, see below.)
- **Engraving distance:** text center = pocket radius + chamfer + 1.5 + half text height = **11.8 mm** below the hole center (specification 11.5 without chamfer; with the 0.3 chamfer only 1.2 mm of margin would remain). "I/O" sits on the display side of the on/off button, 1.5 mm next to the edge of its pocket Ø 15 including chamfer (y ≤ 98.7).
- **Edges:** front and bottom edge chamfered 1.5 × 45° instead of rounded (both lie on the bed when printing; a chamfer prints without overhang).
- **Hook-and-loop strap:** slots 2.5 × 17 outside the battery pocket (x 10…12.5 and 79.5…82), the left rib has a gap there, the right side is open anyway. Previously the slots lay under the battery, the strap could not have been routed around it.
- **USB-C:** cutout 12 × 7 r 2 (socket 9 × 3.3, so ≥ 1.5 mm clearance all round, the wall does not touch the FireBeetle). Outside 15 × 9 r 2 recessed down to 1.2 mm remaining wall, so that an overmolded plug fully enters. An additional relief on the inside would have brought the remaining wall below 1.2 mm. (Cutout replaced by ticket #34, see below; the recess keeps its size.)

## 2026-11-10 · Enclosure: front fields, logo "MPG", grip grooves (ticket #30, user request)

- **Front structure "A · Felder" (A · fields):** three flat fields 0.6 deep, edge chamfered 0.3: display x 22…70, y 9…40.5 r 4; button band x 5.5…86.5, y 74…105 r 5; circle Ø 72 around the handwheel. All ≥ 4 mm from the edge chamfer.
- **Pocket depth in the fields:** button and handwheel pockets stay **1.0 mm below the original front surface** (i.e. 0.4 below the field floor). Remaining plate under the pockets 2.0 mm instead of 1.4: the button head presses on this ring when actuated, and the M12 nut needs support. The pocket remains visible as a 0.4 step in the field.
- **Engravings in the field:** X/Y/Z/A 0.6 deep from the field floor (remaining plate 1.8). The solder-tip pocket of the display stays 0.8 deep: 3 − 0.6 − 0.8 = 1.6 mm plate.
- **Logo "MPG":** Makera "M" (user's template, traced into polygons with `hardware/enclosure/trace_logo.py`, result `logo_polygons.json`) and "PG" in Helvetica bold, cap height 14, common baseline, 1.5 mm spacing, center x 46, y 57, 0.6 deep, width ≈ 44 mm. Black and blue parts are separate faces; the white gaps of the template (≈ 0.26 mm at this size) are widened to ≥ 0.6 mm by shrinking all faces by 0.2 mm. The tips of the diagonals taper to a point and are rounded by printing.
- **Trademark:** The logo is a **trademark of Makera**. For **private use** only, like the logo in the screensaver (ticket #28); remove before any publication. The template (PNG) is not in the repository. **Superseded** by 2026-11-11 (ticket #45): `logo_polygons.json` is git-ignored and stays local; without the file the enclosure engraves "MPG" entirely in Helvetica bold. **Superseded by #50:** committed in the private repository, left out of the public export; used only with `make_enclosure.py --logo`. **Superseded by #46/#50:** the public export has no Git history and does not include the logo.
- **Grip grooves:** only in the two long walls over the whole straight wall, y 12…188, pitch 4, 1.0 wide × 0.8 deep, vertical from z 15.3 to 37.0, rounded ends; the front and the edge chamfer stay untouched (1.5 mm smooth margin below the chamfer). Bottom at 15.3 instead of 14: above the rabbet (up to z 14.2) the outer skin is only 1.3 mm; a groove there would leave 0.5 mm, from 15.3 upward ≥ 1.2 mm remain at the rabbet corner. Left out with 2 mm clearance, computed from the positions of the features: on the right the pocket Ø 15 of the on/off button and "I/O", on the left the USB-C recess. Remaining wall 1.7 mm; on the inside behind the grooves there are no bosses, webs or ribs (corner bosses and webs end before y 12 or after y 188, the handwheel ring keeps 15 mm clearance to the wall).
- **Switch recessed:** like the axis buttons (same parameters `BUTTON_HOLE_D`, `BUTTON_HEAD_D`, `BUTTON_POCKET_D`): hole Ø 12.2, pocket Ø 15 × 1 in the right wall, edge chamfered 0.3, remaining wall 1.5 (enough for the M12 nut). "I/O" and the groove cut-out are computed from the pocket edge including chamfer.
- **Display window:** chamfer 2 : 1, 2.0 mm on the front and 1.0 mm in depth (opening at the front 34.4 × 19.7), the rest of the 2.4 mm plate stays vertical at 30.4 × 15.7. Distance to the field edge ≥ 5.8 mm, inside (pins, solder-tip pocket) untouched.
- **Hook-and-loop channel:** on the outside of the bottom between the two slots a channel 17 wide × 1.5 deep (x 10…82, y 91…108), so that the strap lies flush and the tray sits flat; 1.5 mm of bottom remain.

## 2026-11-10 · Enclosure: handwheel recessed 5.4 mm deeper (ticket #31, user request)

- **Question:** The handwheel's flange stood 5 mm above the front. The user wants it 5.4 mm deeper. Does that fit the handwheel?
- **Measurement (STEP `zss600.step`, mounting surface z 0, axis z):** flange Ø 60 from z 0 to **6.0** (cylindrical 0.3…5.7, chamfered 0.3 at top and bottom), above it a cone Ø 58 → Ø 40.7 up to z 11, scale ring Ø 43 from z 12.5, knob up to z 38. Rear: body **Ø 42.5** from z 0 to −5.5 (step Ø 41.5 to −6), three M3 studs 10 long on bolt circle 50.8 at 12, 4 and 8 o'clock. In reality the body is 22 mm long at the rear (user), the model shows only 10.
- **Decision:** seating surface 6.4 below the front (z 33.6). The flange then ends at z 39.6: 0.4 below the front, 0.2 above the field floor (z 39.4). So 5.4 fits: the flange almost disappears entirely, its upper chamfer is level with the pocket chamfer. Because the front is only 3 thick, a **cup** projects inwards: well Ø 61, wall 2 (outside Ø 65), bottom 2.5 (z 31.1…33.6). In it the cutout **Ø 43** instead of 42.5 (according to the model the body is Ø 42.5, with Ø 42.5 it would sit in the hole without play) and the 3 holes Ø 3.5. The stiffening ring (Ø 44…58) is dropped, the cup bottom is thicker than plate + ring before (2.5 instead of 2 + 1.5 only at the ring). The studs protrude 7.5 behind the bottom: enough for washer and M3 nut on the inside.
- **Wires:** The body (Ø 42.5) reaches 22 behind the seating surface down to z 11.6; 8.6 mm remain to the bottom of the bottom tray (z 3). The 6 wires (bundle ≈ 3) exit at the rear and are bent with bending radius ≈ 3. Placeholder as a chain: bend zone under the whole body 6 high (z 5.6…11.6, 2.6 clearance to the bottom), channel 6 wide out of the body towards the buttons, between body and battery rib (y 121…127) vertically up to z 15…18 and over the battery including hook-and-loop strap to the board edge (y 78), centered between buttons Y and Z (x 43…49). Result: no overlap; clearances 1.0 to buttons Y/Z, 2.0 above the battery (hook-and-loop strap ≈ 1.5 lies in between), 1.9 to the battery rib. No cutout and no recess in the bottom. Previously the placeholder started from the inside of the front plate (z 37 instead of 39), i.e. it was set 2 mm too deep. Whether the real wires (exit style, stiffness) take this route will only be shown by the trial assembly (H-15).
- **Printing:** With the front on the bed, the underside of the cup bottom (the seating surface) hangs 9 mm free in the well. This needs supports only from the bed inside the well, with interface layers (dense contact layer, Z distance one layer); this way the seating surface comes out almost flat and needs at most light scraping. Alternatives examined, none clearly better: chamfer or cone on the seating surface (takes away the flange's flat contact), sacrificial layer over the cutout (a ring with 9 mm overhang cannot be bridged, a bridge across Ø 61 is too long), cup as a separate part (additional seam and screws in the visible area), printing the front shell the other way round (front, fields and engravings would then lie on top on supports).
- **Clearances:** The cup (from z 31.1, edge at y ≥ 117.5) stays far from battery and on/off button; handwheel body Ø 42.5 (model and placeholder) 0.25 to the cutout. Collision check in the README.

## 2026-11-10 · Enclosure: assembly with real STEP models as a separate, ignored file (ticket #31)

- **Question:** The user wants to see buttons, display, board and handwheel as STEP models in the SolidCraft model. Where should they go?
- **Decision:** Separate file `hardware/enclosure/handrad_assembly.sc`, **git-ignored**. Only the generator `make_assembly.py` and its script `handrad_assembly.json` (paths and positions only, no geometry) are checked in. The generator links the enclosure from `handrad_enclosure.sc` (`component.insert_design`), imports the STEP files (`file.insert_step`) with fixed matrices, colors the shells semi-transparent and aborts with a list if a file is missing. `--check` measures overlaps of the real models. `handrad_enclosure.sc` stays free of third-party models.
- **Rationale:** An `.sc` stores imported geometry with it. The models have unclear licenses, the FireBeetle model (SnapMagic, contained in `handrad.step`) must not be redistributed. Therefore they stay local only, as before (`hardware/vendor/`, `fab/handrad.step` are ignored), and so does everything that embeds them. The generator still makes the assembly reproducible, and enclosure changes arrive via the link. **Superseded by #50:** models, `handrad.step` and `handrad_assembly.sc` are committed in the private repository and left out of the public export.
- **Positions (measured from the models):** carrier board: KiCad export, components on top, board x 0…78, y −66…0 → translated by (3.5; 188; 7), no rotation and no mirroring (KiCad already writes the STEP right-handed with y up; ticket y = 12 − STEP y). Display: hole (0; 29) of the model onto the pin (30.8; 12.5), module board on the shoulders (z 35.5), glass 1.5 thick rests against the front, the 0.1 high active area sits in the window. Buttons: axis in the model parallel to y at z 0.538, head towards −y; sealing ring Ø 12.7 × 0.8 behind the head rests on the pocket floor (z 39). On/off: same model, axis x, sealing ring at the pocket floor of the right wall (x 91). Handwheel: seating surface z 33.6, studs without rotation at 12/4/8 o'clock.

## 2026-11-10 · Enclosure: relief above the display flex cable (ticket #31)

- **Question:** The assembly with the real display model shows an overlap of 7.3 mm³ between flex cable and front plate. What is that?
- **Finding:** In the model the flex cable runs 0.1 mm **above** the glass at the lower glass edge (z up to 37.1, x 35…57, y 33.4…43.5) and then around the board edge to the rear. If the glass rests against the front (board on the shoulders), the plate presses 0.1 mm on the flex cable and its bond there.
- **Decision:** relief 23 × 11 × 0.4 in the inside of the front (x 34.5…57.5, y 33…44). Remaining plate in the display field 2.0, outside 2.6; distance to the shoulders of the pins ≥ 1.2, to the window 0.45 (there the glass now rests only on this web and at the sides; the module is held by the pins).
- **Rationale:** Whether the real flex cable lies above the glass or (as with many COG modules) on the lower glass step cannot be told reliably from the model. In both cases the edge with flex cable and driver chip is the most sensitive spot of the module; 0.4 mm of clearance costs nothing. H-15 (b) checks the fit.

## 2026-11-10 · Enclosure: USB-C cutout almost flush (ticket #34, user request)

- **Question:** The test print fits, only the USB-C cutout (12 × 7 r 2) is much larger than the socket. The user wants 0.5 mm clearance all round. Where exactly is the socket? In the user's photo (left wall from outside, front at the top) the hole sits too far to the right relative to the socket, i.e. too far towards the handwheel (+y).
- **Measurement in the model (KiCad STEP `fab/handrad.step`, position per ticket #31: translated by (3.5; 188; 7), ticket y = 12 − STEP y):** metal shell of the socket (body "DFR0654 (112)") at the face **8.94 × 3.16, corner radius 1.3** (profile fitted against circle), face at ticket x 2.5 = **flush with the inner wall surface**. Center **y 32.00, z 22.875** (lower edge z 21.295 = 0.1 above the FireBeetle top side). In the built model the old cutout lay at y 26.0…38.0, i.e. centered on 32.0. The KiCad position matches the enclosure (mounting holes (4.5; 4.5) → bosses (8; 16.5), FireBeetle footprint at y 20 → ticket y 32). **So the model shows 0 offset in y and 0.075 in z.**
- **Measurement on the test print:** From the user's photo (socket width 8.94 as scale) the socket center lies **0.8…0.9 mm towards the display** next to the hole center. In z the socket sits centered (the impression "high in the hole" came from the old cutout, which reached down to z 19.3 below the FireBeetle board z 19.6…21.2). Cause probably the seating of carrier board and module: play of the board on the bosses (hole Ø 3.2 around M3, up to ±0.35), seating of the FireBeetle in the female headers, position of the socket on the real module compared with the SnapMagic model. What counts is the position on the printed enclosure, not the model.
- **Decision:** cutout = socket face + 0.5 per side: **9.94 × 4.16, r 1.8**, center **y 31.2** (0.8 towards the display), z 22.8 unchanged (y 26.23…36.17, z 20.72…24.88). The outer recess **15 × 9 r 2, remaining wall 1.2, keeps its size** (user specification, for thick overmolded plugs) and moves along (y 23.7…38.7). The grip groove cut-out is computed from `USB_Y`; the same grooves are dropped as before. The placeholder `P_USBC` has the measured dimension and sits at `USB_Y` (position of the test print).
- **Check:** placeholder check as in ticket #30/#31 (only the intended contacts). Bottom tray unchanged (STL byte-identical). Against the KiCad STEP (socket at y 32.0) the wall covers the socket face by 0.3 mm on the handwheel side (face rests against the inner wall surface, distance 0, no overlap); that is the difference model ↔ device. With the model at the position of the test print (shifted by 0.8), 0.5 remain at the sides, 0.425 at the top, 0.575 at the bottom.
- **Consequence:** With 0.5 clearance the cutout tolerates only little position error of the board. If the plug rubs on the next print, measure on the device and adjust `USB_Y` in `make_enclosure.py`.

## 2026-11-10 · Feed rate from turning speed, bundling, window 5 mm XY / 1 mm Z (ticket #32)

- **Question:** On the real Z1 Pro the machine stutters badly when turning faster, at medium speed the display often shows `Begrenzt` (limited). What causes this, and how does it become smooth without weakening jog gate, planner and window?
- **Firmware finding** (github.com/MakeraInc/MakeraZ1Firmware, tag v1.1.3, read only):
  - `$J` (`SimpleShell::jog`, `src/modules/utils/simpleshell/SimpleShell.cpp` l. 1916–1985): `F` is a factor (l. 1944) on the smallest `max_rate` of the moved axes (l. 1962–1972), followed by `delta_move(delta, rate × F)` (l. 1982) and `force_queue()` (l. 1984), i.e. without the 100 ms collection delay of the queue (`src/modules/robot/Conveyor.cpp` l. 76, 187). `F ≤ 0` is silently discarded (`src/modules/robot/Robot.cpp` l. 1744).
  - Multi-axis (XY): the rate applies to the path, i.e. the XYZ length (`Robot.cpp` l. 1564, 1633); each axis is throttled to its `max_rate` (l. 1685). So for XY at 45° each axis moves at rate/√2.
  - Axis A alone: the firmware converts the rate via the rotation radius and, for a small radius, accelerates up to about 10×, at most to the A maximum rate (`Robot.cpp` l. 1646–1666).
  - Planner (`src/modules/robot/Planner.cpp`): the newest block is always planned with exit speed `minimum_planner_speed` (l. 325), default 0 (l. 47). Two blocks on the same straight line are joined without stopping, junction speed `min(nominal_vorher, nominal_jetzt)` (l. 175–203); junction deviation (Z1 Pro: 0.01 mm, `src/configZ1Pro.default` l. 35) only applies at corners. **So `F` may change per command without the machine stopping.**
  - A running block is no longer replanned (`src/modules/robot/Block.cpp` l. 153) and passes on to its successor the exit speed planned at its start (l. 304). **If a block starts while it is the last one in the queue, it ends at standstill**, even if a new `$J` arrives immediately afterwards.
  - **Queue:** `planner_queue_size` default 32 (`Conveyor.cpp` l. 75), not set in `configZ1Pro.default`. If it is full, `Conveyor::queue_head_block` (l. 157–160) waits and calls `ON_IDLE` while doing so. `SerialConsole::on_idle` (`src/modules/communication/SerialConsole.cpp` l. 500–526) keeps reading frames there (`on_serial_char_received`, l. 509): `?` is still answered (l. 523–526), but a console frame (`0xA2`, l. 190–201) is executed immediately via `ON_CONSOLE_LINE_RECEIVED`, i.e. another `$J` **nested** inside the wait of the first one. `Kernel::call_event` does not protect against re-entry (`src/libs/Kernel.cpp` l. 752–764). The inner `$J` writes, via `Planner::append_block`, the same not-yet-queued head block (`Planner.cpp` l. 57, 73) as the waiting outer one, computes from a stale `machine_position` (`Robot.cpp` l. 1750, 1760) and nests the stack deeper. Result: lost or corrupted motion. **A full queue must be ruled out**, not merely unlikely.
  - Maximum rates Z1 Pro (`configZ1Pro.default` l. 439–446): X/Y 1200 mm/min, Z 600 mm/min, A 3600 °/min, acceleration 150 mm/s² (A 360 °/s²).
- **Cause:** With a fixed `F1.000` (20 mm/s) every short segment was finished before the next detent arrived. Every block started as the last one, braked to 0, the machine waited: stop-and-go. In addition, `mpos` lags behind by about 0.4 s because of the 100 ms status interval and the gaps of up to 430 ms; at medium speed this alone already filled the 2 mm window (`Begrenzt`).
- **Decision feed rate:** `F` per command from the turning speed (new `lib/core/feed_rate.h/.cpp`, SPEC 8.7 "Feed rate"): `F_milli = ⌈v × 0.92 × p / MAX_RATE × 1000⌉`, limited to `[F_MIN_MILLI = 20, F_SCALE_*_MILLI]` (XY 1000, Z 500, A 500 as upper limits as before), `p = √2` for XY. `v` = sum of `want = |detents| × step_um` over the last 200 ms (own ring buffer `FeedEstimator` in the planner, measured only during a session, cleared at session start and end).
- **Why lead 0.92 and not above 1** (review, fresh context): A first draft had 1.3. If the machine moves faster than turned, it works off the backlog down to its braking distance `v²/2a` (at 3 mm/s 0.03 mm, less than one block of 0.06 mm). Almost every block then starts as the last one and ends at standstill: 50 Hz judder. With 0.92 the backlog grows by 8 % of the turned distance, at most up to the window, and there are always blocks in the queue. Price: somewhat more overrun, about `0.09 × turning duration + 0.2 s` (derivation SPEC 8.7), always at most the window. The same formula is applied for A; the firmware then usually moves A faster anyway.
- **Decision bundling (SPEC 8.7 e1):** After the first command of a session, detents are collected and sent as one command in the tick `BUNDLE_MS = 40` after the first collected detent (3 ticks = 60 ms of turning per block). Sending is immediate only when no handwheel block can still be queued (machine is certainly standing; this is always the first command, so the session start on a fresh Idle stays unchanged, and a single detent reacts immediately). Time instead of minimum length: a minimum length (e.g. 0.1 mm) would hold back slow detents for arbitrarily long; the time limit delivers blocks that grow with the speed (at 5 mm/s 0.3 mm), and sends the remainder on release at most 40 ms after its first detent. **Send instead of discard on release:** every detent should arrive (detent-exact); the remainder lies on the same tick grid as before and only goes out if all conditions of a command hold.
- **Safety when bundling:** collected detents are discarded on hold (a0/a1), lock, missing status, axis change, every session end and on direction reversal. Sending happens only in a tick that has passed (a), i.e. with gate None, status and the same axis. The window applies to the bundled amount, the collected value is additionally limited to the window. Tests 80–81.
- **Decision upper limit (SPEC 8.7 e2):** at most `JOG_MAX_QUEUED = 12` handwheel blocks that may be queued. Why needed despite bundling: with long slow turning the backlog can reach 5 mm, at 0.4 mm/s that is 12 s, i.e. up to about 200 blocks of 60 ms each. When the limit is reached, collecting continues and is sent later as a longer block. Test 82.
- **Counting (second review):** A first draft counted each block individually as "queued" as long as `mpos` had not reached its end (in its direction). After a reversal `mpos` moves back behind the ends of the old forward blocks; they then counted as phantoms until session end (reviewer's simulation: up to 15 phantoms, one real slot, stop-and-go). And a block after a reversal within the 10 µm band was considered finished immediately if an older status happened to lie on its end. Now: list in send order (the firmware processes in this order); a block is considered finished when a status received at least `START_GAP_MS` after it was sent (same rationale as c.3: its content certainly stems from after the `$J`) shows `mpos` at most `ARRIVE_UM` before its end; then all older ones are finished too. The tolerance `ARRIVE_UM` deliberately accepts that the count is too low (third review): because every sent block is at least `ARRIVE_UM` long (`STEP_UM[0] = 10`, and a block capped below 10 µm by the window is now discarded instead of sent; previously such blocks could drive the deviation up to 2 in a row), it is at most **one** block too few, directly after a reversal at most two (test 89). Without tolerance, a block whose reported end position lies 1–10 µm before the target due to step rounding would remain as a phantom, and a detent after a pause would be collected and discarded in the same tick with the session end (g) (test 87). With 12 of 32 slots there is enough reserve for this. Tests 84–88.
- **Why 12 instead of 16 (second review):** If a new session starts on a stale Idle (residual risk 8.7 c.3), the list is cleared although blocks of the old session may still be queued. 2 × 16 = 32 would be exactly the full firmware queue. With 12 and the counting bound (at most 2 too few per session) it is at most 2 × (12 + 2) = 28 < 32; the rest is reserve for blocks of other clients. Test 85.
- **Assumptions checked (second review):**
  - *A `$J` is at most one planner block.* True: `SimpleShell::jog` → `Robot::delta_move` (`Robot.cpp` l. 1739–1765) calls `append_milestone` directly (l. 1759), not `append_line` (l. 1768 ff., where segmentation via `mm_per_line_segment` happens). `append_milestone` appends exactly one block (l. 1724). If a tiny motion results in no steps, no block is created at all (`Planner.cpp` l. 91–95); then the count is merely too high.
  - *`MPos` is the real axis position, not the target of the last block.* True: `Kernel::get_query_string` (`src/libs/Kernel.cpp` l. 341) takes `Robot::get_current_machine_position` (`Robot.cpp` l. 404–415), which computes from `actuators[]->get_current_position()`, i.e. from the current step counter (`src/libs/StepperMotor.h` l. 46: `current_position_steps / steps_per_mm`). `machine_position` (the target) is not used for this.
- **Lead for A (second review):** The formula with 0.92 applies uniformly to all axes, including A (code and test 55). The firmware then usually moves A faster anyway (see finding above).
- **Rationale of the speed measurement:** Not `StepPolicy::v × step_um`: its window is 500 ms long (too sluggish when starting), has a resolution of only 2 detents/s and multiplies old detents by the *current* step size (up to 10× wrong on a step level change). A separate moving average over `want` in µm directly measures the distance the user requests, independent of the level. `want` instead of `move`: if the window caps, the machine is behind, and that is exactly when `F` should not drop. 200 ms: 10 ticks, fast reaction. Integer and deterministic, time as a parameter, hence testable natively (tests 76–79, 83).
- **Decision window (user):** `WINDOW_UM` X/Y 2000 → **5000**, Z 500 → **1000**, A stays 2000. The user decided this after being told about the longer overrun. Consequences: overrun at most 5.01 mm (XY) or 1.01 mm (Z); `session_consistent` now tolerates 5.1 mm or 1.1 mm; all residual risks "at most one window" (job start, foreign commands, buffered frames) or "about double window" (stale Idle) grow accordingly (up to about 10 mm XY, 2 mm Z).
- **Unchanged:** jog gate (8.5), session start, direction lock, hold on data loss, session end, status interval 100 ms (separate ticket #33).
- **Residual risks and open points:**
  - `MAX_RATE_UM_S` comes from the default configuration. If the user has changed the machine rates, only the speed is off; the upper limits still apply. **Addendum ticket #38:** On the real Z1 Pro the assumption did not hold (3000/3000/1000 instead of 1200/1200/600 mm/min); since then the rates are read via `M203.1` after every connect, the upper limits are absolute speeds (entry 2026-11-11 below).
  - After very long slow turning the overrun can take longer than 3 s (`SESSION_MAX_IDLE_MS`) (distance still at most one window). Then the session ends and the handwheel shows `Maschine belegt` (machine busy) until Idle arrives.
  - Blocks of other clients occupy the same queue. The jog gate protects against a job running at the same time; for small foreign motions the reserve of 32 − 28 = 4 slots remains.
  - It is not entirely without stops: slower than `F_MIN` and for A the machine moves faster than turned; on status gaps (a0) collected detents are discarded. Whether 0.92, 200 ms and 60 ms suit the real machine well is checked by H-16 (with A/B comparison 0.92 versus 1.30); the values live only in `core_config.h`.

## 2026-11-10 · OTA update over Wi-Fi (ticket #35, user decision)

- **Question:** OTA was listed in SPEC ch. 14 as "out of scope". The user wants to flash the firmware over Wi-Fi. How does that work without the machine ever moving unexpectedly?
- **Decision scope (user):** OTA comes into scope, SPEC ch. 14 removed, new section SPEC 9.5. ArduinoOTA (espota), partition table `default_16MB.csv` unchanged (`app0`/`app1` 6.25 MB each, firmware about 1.3 MB).
- **Decision enabling and password:** New checkbox "Update über WLAN erlauben" (allow update over Wi-Fi), NVS key `ota` (bool, default off), in the portal and `/settings` via the shared `settings::append_fields`/`save_form`. Off → `ArduinoOTA.begin()` is never called, port 3232 stays closed. Password = `ap_pass` (handwheel password): it is already the secret for saving the settings; a second one would have to be readable somewhere for the user and would have the same protective effect. ArduinoOTA 3.3.x stores only the SHA-256 and checks via a PBKDF2-HMAC-SHA256 challenge (`ArduinoOTA.cpp` `_onRx`, state `OTA_WAITAUTH`); the password does not travel over the network in plain text. It never appears in the repo: `platformio.ini` reads `--auth=${sysenv.HANDRAD_OTA_PASS}`.
- **Finding ArduinoOTA** (`framework-arduinoespressif32` 3.3.12, `libraries/ArduinoOTA/src/ArduinoOTA.cpp`, read only):
  - `handle()`: if `_state == OTA_RUNUPDATE`, `_runUpdate()` runs first, then a UDP packet is read (`_onRx`). Invitation (`OTA_IDLE` → `OTA_WAITAUTH`, response `AUTH <nonce>`) and password check (`OTA_WAITAUTH` → `OTA_RUNUPDATE`) thus run in separate `handle()` calls, and the transfer at the earliest in the **next** `handle()` call after the check.
  - `_runUpdate()`: `Update.begin()`, then `onStart`, then TCP connection to the computer and the whole transfer in a loop with `delay(1)`; so it blocks `loop()` until the end. After success `Update.end()` (MD5 checked, boot partition switched), `onEnd`, with `setRebootOnSuccess(true)` immediately `ESP.restart()`. All error paths after `onStart` call `onError` (connection, receive, finish; "No Data" and "failed to respond" fall through to `Update.end()` → `OTA_END_ERROR`) and return with `OTA_IDLE`.
  - `end()`: closes the UDP socket and sets `_state = OTA_IDLE`; with `setMdnsEnabled(false)` it leaves mDNS alone. `begin()` after `end()` reopens the port (`_initialized` is reset).
  - `begin()` with mDNS calls `MDNS.begin(hostname)` → `mdns_init()`. The web UI has already done that; a second `mdns_init()` fails (`ESPmDNS.cpp` `begin`). 
- **Decision acceptance and race:** Pure rule `ota_update_allowed(axis, session_active, battery_warn)` in `lib/core/settings_rules` (`settings_change_allowed` and no weak battery), test 90. `ota::step(ota_allowed())` is the last step of `loop_normal()`, the rule is evaluated immediately before it with the state after the tick. If it does not hold, `ArduinoOTA.end()`; if it holds, `begin()` if needed and `handle()`. Thus:
  - `_runUpdate()` only runs in a `handle()` call before which the rule held in the same pass, and no tick runs between check and call (same rationale as for saving the settings, SPEC 9.1 steps 3–5);
  - no login begun in an earlier pass (`OTA_WAITAUTH`/`OTA_RUNUPDATE`) can outlast a lock: every lock resets the state via `end()` and discards waiting UDP packets together with the socket. Without this, a delayed invitation that arrived during a lock would still be processed after deselection and could later trigger a restart;
  - with an axis selected, espota gets no response and aborts ("No response from the ESP"; if the lock came only after login, "No response from device"), that is the rejection.
  - `onStart` checks the rule once more anyway (defense in depth) and rejects everything except `U_FLASH` (no file system update, the SPIFFS partition is not used).
- **Decision at start:** `onStart` ends the session and calls `machine::stop()` (socket closed in an orderly way, afterwards `send_line()` always fails, as with the battery shutdown). The loop then sits in `handle()`, so no tick, no `$J`, no axis selection. Display "Update" with percentage, serial `OTA: …`. `setRebootOnSuccess(false)`: after returning from `handle()`, `ota::step()` **always** restarts once `onStart` has run, on success as well as on error or abort. Reason: after an error, socket and session are already closed; a restart is the simplest safe starting state, and the user sees on the display what happened. Errors **before** `onStart` (wrong password, `Update.begin` fails) change nothing and do not restart, otherwise anyone on the network could make the handwheel restart with wrong passwords.
- **Decision mDNS:** `setMdnsEnabled(false)` and `MDNS.enableArduino(3232, true)` on the existing responder of the web UI (`_arduino._tcp`, `auth_upload=yes`). OTA therefore only starts after `webui::begin()`. The computer resolves `upload_port = handrad.local` itself via mDNS; the IP works just as well.
- **Battery, screensaver, watchdog:**
  - *Battery:* During the transfer (about 10–30 s) the loop does not measure. Therefore the rule accepts no update on `battery.warn()` (below 3400 mV, not on USB without battery). A brownout during writing resets; the boot partition is then not switched, the old firmware starts. A `critical()` cannot occur in `loop_normal()` (leads to shutdown beforehand).
  - *Screensaver:* Does not run during the transfer (no tick). `display::show_ota()` turns a switched-off display back on after drawing (like `show_battery_empty`). Drawing only happens on a changed percentage value and at most at `DISPLAY_MAX_HZ` (one frame about 23 ms).
  - *Watchdog:* `loopTaskWDTEnabled` is `false` by default in the Arduino core (`cores/esp32/main.cpp`), the task watchdog (5 s) only checks the idle task of CPU 0 (`CONFIG_ESP_TASK_WDT_CHECK_IDLE_TASK_CPU0=y`, CPU 1 not). The loop runs on CPU 1, Wi-Fi/lwIP on CPU 0 are not starved, `_runUpdate` yields via `delay(1)`. No intervention needed.
- **Rollback:** `CONFIG_BOOTLOADER_APP_ROLLBACK_ENABLE=y`, but Arduino marks the new firmware as valid immediately in `initArduino()` (`verifyRollbackLater()` = false). Deliberately left like this: a delayed confirmation (e.g. only after "Online") would silently fall back to the old firmware when switching off shortly after the update. A new firmware that does not get onto Wi-Fi needs USB.
- **Residual risks:**
  - The PBKDF2 check (10,000 rounds, estimated 0.5–1 s) blocks the loop once per login attempt, only at `axis == None` without a session (i.e. without moving). H-17 measures the duration (serial `OTA: handle() dauerte … ms` (handle() took … ms)). Beyond `LINK_STATUS_TIMEOUT_MS` the connection to the machine would be torn down once and re-established. A key press during the check can be lost.
  - **Lock after wrong password (review, fresh context):** Without a lock, a client on the LAN without the password could send invitation and response in lockstep and keep the loop almost permanently in PBKDF2. Now after `OTA_AUTH_ERROR` the UDP port stays closed for `OTA_AUTH_LOCK_MS = 5000` (`AuthThrottle` with its own duration, test 91), via the same path as with an axis selected (`end()`, later `begin()`). **Why 5000:** with a check of at most about 1 s, the loop stands for at most about one sixth of the time and never twice in direct succession, so never longer than one check at a stretch (well below `LINK_STATUS_TIMEOUT_MS = 3000` together with the next status). Guessing is slowed to at most one attempt per 5 s (10⁸ possibilities: years). Whoever mistypes only waits 5 s. Longer would bring hardly more protection, only more waiting time. An invitation alone costs nothing (only a nonce), responses with the wrong length are discarded without PBKDF2. Consequence: espota's automatic MD5 second attempt (see below) gets no response, a wrong password results in one check.
  - **Port not bound (review):** `ArduinoOTA.begin()` reports a failed `udp bind` only via `log_e` and then stays silently off. `ota.cpp` first binds the port on a trial basis with the same call (`NetworkUDP::begin(IN6ADDR_ANY, 3232)` with `CONFIG_LWIP_IPV6`), closes it and only then calls `begin()`. If the trial fails, a new attempt at most every `OTA_LISTEN_RETRY_MS = 5000` (like port 80 of the web UI, but rarely enough that sockets are not burned through), reported once on serial.
  - Anyone who knows the handwheel password and is on the same network can install arbitrary firmware (which could also move the machine). Therefore off by default. The 8-digit numeric password is slowed against guessing by the PBKDF2 duration, but not locked.
  - espota (`tools/espota.py`), after a failed SHA-256 attempt, automatically tries again with an MD5 password hash (new invitation). Because of the lock this second invitation gets no response ("Failed to get new challenge for MD5 retry"); on serial once `OTA: abgelehnt (Passwort falsch)` (rejected (wrong password)).

## 2026-11-11 · Web UI redesigned, position map (ticket #36)

- **Question:** The status page was a bare table ("just looks bad"). How does it become appealing and show the position of the tool graphically without violating SPEC 9.1 (flash only, nothing external, non-blocking server, unchanged `/status.json`)?
- **Decision look:** Own, restrained workshop look: aluminium grey as background, cards, one accent blue, state colors green/blue/yellow/red, spoilboard in MDF brown as the only "image". System font (`system-ui`), tabular digits. Light/dark only via `prefers-color-scheme`, no toggle. No manufacturer logo, own handwheel symbol (inline SVG). Portal and `/settings` use the same header and style (`WEB_PAGE_HEAD` in `src/web_pages.h`, `settings::kPageHead` is now only this macro). The status page additionally gets its own CSS, the form pages additionally `WEB_FORM_CSS`; so no page carries foreign CSS.
- **Decision size and heap:** The status page grows from 2192 bytes to 12,223 bytes (167 bytes dynamic beginning + 12,056 bytes flash part, measured with `tools/dump_web_pages.cpp`; target below 12 KiB = 12,288 bytes). So that it does not occupy a 12 KB `String` per connection on the heap, `webui.cpp` sends it in two parts: `resp` (`String`) = header + dynamic beginning (doctype, calibration object `C`, 167 bytes), then `Conn::tail` = `kStatusTail` directly from flash (`.rodata` in DROM, `nm`: 0x3f40…, no RAM). `send_some()` sends one piece from `resp` or from `tail` per call, as before one `lwip_send(MSG_DONTWAIT)` per pass and connection, `Content-Length` = sum. The heap per status page response thereby drops from about 2.4 KB (plus an equally large intermediate copy) to about 0.35 KB. Gzip was rejected: it needs a build step and does not tolerate the dynamic beginning. Server, routes, limits, timeouts, POST order and `/status.json` are unchanged; `<link rel=icon href="data:,">` also spares the handwheel the `/favicon.ico` request (previously 404).
- **Decision position map:** 2D top view as inline SVG in machine coordinates (mm, y up). Crosshair at the MPos, workpiece zero = MPos − WPos (quarter circle), Z as a bar, A as a disc only with `has_a`. The markers glide via CSS transition (0.9 s) to the new position, the numbers always show the last real value; markers outside the map are clamped to the edge. Polling still 1/s, the next only after the response, abort after 3 s (AbortController), then "Keine Verbindung zum Handrad" (no connection to the handwheel) with the age of the last response. For #37 (3D) each view is a function in `V` that receives the `/status.json` object (or `null`); the 3D view can hook itself into `#view` next to it.
- **Decision spoilboard geometry:** Outline and holes come from `hardware/vendor/spoilboard/Makera-Z1_MDF-v2.1.STEP` (git-ignored, Makera geometry, **private use only** like the logo in the screensaver, remove or replace before a publication; **superseded by #50:** the STEP is committed in the private repository and left out of the public export, the derived header is exported; **superseded by #46:** the public export has no Git history and includes neither the STEP nor the logo). The downloaded file is considered untrusted: `tools/make_spoilboard_geometry.py` is an own text parser (only `CARTESIAN_POINT`, `DIRECTION`, `AXIS2_PLACEMENT_3D`, `CIRCLE`, `LINE`, `EDGE_CURVE`), invoked isolated with `python3 -I tools/make_spoilboard_geometry.py <STEP> > include/spoilboard_geometry.h`, nothing from the vendor folder is executed. Result: board 206 × 206 × 6 mm with 1 mm chamfers at the corners, 54 holes: 36 counterbored holes (Ø 10 mm, 2 mm deep, below Ø 5.5 mm), 17 through holes Ø 5 mm, one Ø 10.5 mm. Only the generated header is in the repo (coordinates in 0.1 mm, origin front left corner, x right, y back), about 0.9 KB in the page.
- **Values from the machine** (user, read only `config-get sd <key>` on 2026-11-11, Makera Z1 firmware, Smoothie fork; `Robot.cpp` sets `soft_endstop_max = -1` fixed): `soft_endstop.enable = true`, `x_min/y_min/z_min = -207/-206/-102` mm, maximum −1 mm → travel MPos X −207…−1, Y −206…−1, Z −102…−1 mm (`UI_TRAVEL_*` in `include/ui_config.h`, confirmed). Also read, currently unused: `coordinate.anchor1_x/y = -191.58/-194.14` (anchor 1, front left workpiece reference corner), `anchor2_offset_x/y = 88.5/45.0`, `anchor_width = 15.0`, `anchor_length = 100.0`, `rotation_offset_x/y/z = -7.5/69.0/17.0` (A module), `toolrack_offset_x/y = 48.8/181`, `toolrack_z = -108`, `clearance_x/y/z = -11.6/-14.6/-3.0`. So soft endstops are active on this machine; the recommendation in `WIRING.md` is fulfilled (noted there).
- **Decision spoilboard position (estimated):** The position of the spoilboard in MPos is not measured. Estimate: front left board corner = travel minimum (−207/−206 mm; board 206 mm, travel 206 × 205 mm). Then anchor 1 lies at 15.42/11.86 mm from the corner, matching the 15 mm wide anchor strip. An anchor pocket cannot be clearly identified in the hole pattern (the Ø 5 mm row at x = 20 or y = 20 mm on the 45 mm grid fits anchor screws, but is not conclusive), therefore `UI_POS_CALIBRATED = false` stays and the page shows "Plattenlage geschätzt, noch nicht eingemessen" (board position estimated, not yet measured). Assumption in addition: board axis-parallel, not mirrored. Measure in per H-18 (d): move the tool over the counterbored hole front left (30.0/7.5 mm), state MPos → corner = MPos − (30.0/7.5), enter in `ui_config.h`, flag to `true`.
- **Check:** `tools/dump_web_pages.cpp` writes the status page byte for byte as sent, as well as portal/`/settings` (form reproduced statically) as HTML; viewed with mock `/status.json` (Idle, jogging XY/Z, alarm, no status, stale, job, A axis, no response) in Chromium at 390 and 1280 px, light and dark. On the device: H-18.

## 2026-11-11 · 3D view of the position with three.js from flash (ticket #37)

- **Question:** How does a 3D view (three.js) get onto the status page without internet, without disturbing the loop, and such that an OTA update brings it along?
- **Decision storage (deviating from the ticket, which planned LittleFS):** No file system. OTA (9.5) only accepts `U_FLASH`; a LittleFS image would need USB, and firmware and page could drift apart. Instead the files lie gzip-compressed as `const uint8_t[]` in the firmware image (`src/web_assets.h`, `.rodata` in DROM, `nm`: 0x3f40…, no RAM). App partition 6.25 MB; firmware 1,284,434 → 1,464,886 bytes (+180,452, of which 178,094 assets). `board_build.embed_files` was rejected: with objcopy the symbol names depend on the path of the source file, which is unwieldy in the Arduino build.
- **Decision three.js:** Version 0.160.0 pinned (npm, published 2023-12-22, MIT), `build/three.module.min.js` (166,230 bytes gzip) and `examples/jsm/controls/OrbitControls.js` (6,521 bytes gzip, import of `'three'` rewritten to `./three-0.160.0.js`, since there is no import map). No own bundling/tree shaking: the `WebGLRenderer` pulls in most of it anyway, a bundler would be another executed piece of third-party code in the build for maybe 40 KB. The npm tarball was downloaded once into an empty directory (integrity sha512 `DLU8lc0z…uDhng==` checked), read only; `tools/make_web_assets.py --three <paket>` checks the SHA-256 of the three files used and writes `web/vendor/*.gz` (deterministic, gzip -9 without timestamp) and `web/vendor/three-LICENSE`. The MIT notice is in the header of `three.module.min.js` and as a comment in the OrbitControls, hence also in the firmware. The 3D view itself is `web/view3d.js` (5.3 KB gzip), path with content hash (`/a/v3d-<8 hex>.js`, `src/web_asset_paths.h`). After the review: OrbitControls also gets a content hash path (`/a/oc-<8 hex>.js`; due to the rewritten import its bytes are our own), `web/view3d.js` imports the placeholder `./oc.js`, which the generator replaces. three.js keeps the version path: its content is the unchanged npm file whose SHA-256 the generator checks on every run; a different file would mean a different version. For all files in `web/vendor/` the SHA-256 of the (unpacked) content is in the generator and is checked on every run; the CI job `web-assets` regenerates the headers and fails on deviation (`git diff --exit-code`). The generator writes the gzip header itself (mtime 0, OS 255), so that the result does not depend on the Python version; the deflate stream comes from zlib (classic zlib yields the same bytes on macOS and in the CI image `python:3.12`, zlib-ng does not).
- **Decision serving:** Routes `/a/three-0.160.0.js`, `/a/oc-<hash>.js`, `/a/v3d-<hash>.js`, directly from flash via the existing `Conn::tail` mechanism (one `lwip_send(MSG_DONTWAIT)` per pass and connection, no heap, 2 connections, limits unchanged), `Content-Encoding: gzip` always (every browser with ES modules and WebGL can do gzip), `Cache-Control: public, max-age=31536000, immutable`. A new three.js gets a new version path, a changed 3D view a new hash; so after OTA the browser loads the new version without anyone clearing the cache.
- **Decision timeout:** 170 KB do not fit into the previous 2 s budget per response. For the files a progress-based limit applies while sending (`web_send_expired`, test 92): the connection is closed after `WEB_REQ_TIMEOUT_MS = 2000` without one accepted byte or at the latest after `WEB_ASSET_SEND_MAX_MS = 30000` in total. Pages and JSON keep the 2 s (upper limit = `WEB_REQ_TIMEOUT_MS`), reading the request stays at 2 s. So a hanging client occupies a slot for at most 2 s without progress, a slow one for at most 30 s.
- **Loop estimate:** One `lwip_send` takes at most the free send buffer (`CONFIG_LWIP_TCP_SND_BUF_DEFAULT = 5760` bytes) and copies it from the mapped flash; estimated well under 1 ms per call, so two connections under 2 ms per pass, only while loading. Throughput is limited by TCP window and radio link (estimated 0.2–1 s for 178 KB), not by the loop. Measured on the device (H-19 b, `max. Web`, `max. Loop`). The status poll and a `POST /settings` may wait while loading until a slot becomes free (at most `WEB_ASSET_SEND_MAX_MS`); the poll aborts after 3 s, the page briefly shows "Keine Verbindung" (no connection) and tries again. No effect on safety: the web UI never talks to the machine, `settings_allowed` is checked in the pass of saving.
- **Decision page:** 2D stays default and fallback. Toggle "2D | 3D" in the header of the position map, choice in `localStorage` (in `try/catch`). The 3D module is only loaded via `import()` when 3D is selected; if that fails (no WebGL, loading failed), 2D stays with a notice, the choice is reset. For this the status page grows from 12,223 to 13,618 bytes, the target rises from 12 KiB to 14 KiB; the heap per response stays about 0.35 KB (flash tail). Rendering happens only on a new status, while gliding and on interaction; pixel ratio at most 2. Scene, colors and controls: SPEC 9.1.
- **Decision spoilboard top (estimated):** `UI_BOARD_TOP_MPOS_Z_UM = -102000` (= Z minimum of the travel), not measured; the MPos Z depends on the tool length, a fixed value is only an approximation anyway. Applies with `UI_POS_CALIBRATED`, hence the same notice "Plattenlage geschätzt" (board position estimated). (No longer since ticket #40: see there.)
- **Decision rotary axis module (estimated, user request):** With `has_a` the 3D view shows a rotary axis module with axis parallel to X, the stock rotates with A. Position from the machine configuration (`config-get`, ticket #36): `coordinate.anchor1 = -191.58/-194.14`, `coordinate.rotation_offset_x/y/z = -7.5/69.0/17.0`. Makera Studio (CarveraController `makera.py`: zero point "from Headstock" = `anchor1 + rotation_offset`, position of the module rectangle on `rotation_offset_y`) and the firmware (`ATCHandler.cpp`: probing position of the module `anchor1_x + rotation_offset_x − 3/−7`, `anchor1_y + rotation_offset_y`; `G10 L20 P0 Z rotation_offset_z` on the probing surface, comment "relative to chuck center") use `anchor1 + rotation_offset` as the reference point of the headstock on the rotary axis. From this: `UI_A_AXIS_MPOS_X_UM = -199080` (chuck/headstock reference), `UI_A_AXIS_MPOS_Y_UM = -125140` (axis). The axis height is not in the configuration (`rotation_offset_z` is the WCS Z value on the probing surface, relative to the axis center, not its MPos): placeholder `UI_A_AXIS_HEIGHT_UM = 30000` above the spoilboard top. `UI_A_POS_CALIBRATED = false`, the view writes "Lage der Drehachse geschätzt" (rotary axis position estimated) next to the angle. The geometry (base plate, headstock, chuck with three jaws, stock Ø 40 × 150 mm with marker stripe, tailstock with center) is a **placeholder**, not the Makera part. The spoilboard is still drawn completely (the module partly covers it). A is shown gliding linearly (on the machine continuous degrees, no wrap at 360°). The 2D map does not show the module (page size); separate ticket if needed. Check on the device: H-19 (d).
- **Check:** `tools/dump_web_pages.cpp` now also writes `a/*` (gzip as sent); locally with a small server (assets with `Content-Encoding: gzip`, moving mock `/status.json`, also with A) in Chromium at 390 and 1280 px, light and dark, without console errors; fallback checked with a missing file and with WebGL disabled. On the device: H-19.

## 2026-11-11 · Read maximum rates at runtime, top speed fixed (ticket #38, user decision)

- **Finding:** Machine configuration of the user's Z1 Pro (firmware 1.1.3.0.1.13) read over Wi-Fi on 2026-11-11, read only: `download /sd/config.txt` and `/sd/config.default` (tool `tools/z1_config_download.py`, protocol like MakeraInc/CarveraController `XMODEM.recv`), cross-checked with `config-get sd <key>`. Both files: `alpha_max_rate 3000`, `beta_max_rate 3000`, `gamma_max_rate 1000` mm/min, `delta_max_rate 3600` °/min, `acceleration 150` mm/s². The assumption from #32 (`configZ1Pro.default` of the public repo v1.1.3: 1200/1200/600 mm/min) is **outdated** for this machine. Consequence: `F = v × 0.92 / MAX_RATE` was too large, the machine moved X/Y about 2.3 times and Z 1.5 times as fast as turned instead of 0.92 times, caught up with the backlog, every block started as the last one (stop-and-go, SPEC 8.7 "Feed rate"). And the top speed at `F_SCALE` was 50 instead of 20 mm/s (X/Y) or 8.3 instead of 5 mm/s (Z). The distance stayed limited by the window.
- **First decision (rejected):** Fixed rates `{50000, 50000, 16667, 60000}` in `core_config.h`, no reading at runtime. **User decision:** The rates come from the machine at runtime, not entered as fixed values. Rationale: there are already two different values (public default, real machine); a firmware update or a change by the user would silently make them wrong again.
- **Firmware finding query** (MakeraZ1Firmware v1.1.3, read only): `M203.1` without arguments (`src/modules/robot/Robot.cpp` l. 882–897) outputs `actuators[i]->get_max_rate()` for X, Y, Z and every further non-extruder actuator, format ` %c: %g ` in mm/s (A in °/s), followed by end of line and `ok` (`GcodeDispatch.cpp` l. 414–430). Exactly this value is what `$J` uses as the reference for `F` (`SimpleShell.cpp` l. 1962–1972). It contains everything the file does not show: `config-override` (M500 saves `M203.1`, `Robot.cpp` l. 1047–1052), the correction in `check_max_actuator_speeds` (l. 511–520) and the capping of A to 1800 mm/min when `FuncSetting` bit 0 is set (l. 295–299). `config-get sd alpha_max_rate`, by contrast, reads only the file. **Hence `M203.1`.** With arguments `M203.1` sets the rates; the handwheel sends the constant `RATE_QUERY_TEXT = "M203.1"` (test 95). No error path: without arguments the command sets no `is_error`, so it triggers no HALT. In HALT the firmware rejects the command (203 is missing from `allowed_mcodes`, `GcodeDispatch.cpp` l. 34, 176–185): in grbl mode (`grbl_mode`, `Kernel.cpp` l. 206) with `error:Alarm lock`, otherwise with `!!`. `error:…` would have overwritten the handwheel's alarm line (e.g. `ALARM: Hard limit`) on every attempt and kept the display awake (review); therefore no query is made at all in alarm and when `halted` (`RateQuery::ready`), the next query goes out immediately after the alarm (test 98).
- **Decision sequence** (SPEC 8.8 "Machine rates"): `RateQuery` in `lib/core/machine_rates` (pure, tested natively), driven by `machine_link.cpp`: after the first status of every connection one query, at most one at a time, timeout 1 s, retry after 1 s, 2 s, 5 s, then every 5 s; every disconnect resets (re-read on every connect). The `?` cycle and `LINK_STATUS_TIMEOUT_MS` stay untouched; a query that cannot be sent is a socket error like an unsent `?`. Only after the first status, so that the machine is certain to respond and the query does not coincide with the connection setup.
- **Decision parser:** Only lines beginning with `X:` count as a response; everything else (status, `ok`, output of other clients mirrored by the Wi-Fi module) is ignored. A response must consist entirely of `<Buchstabe>: <Zahl>` pairs (X, Y, Z exactly once, A at most once, B/C ignored), otherwise it is discarded. This also discards the response to a plain `M203` (Cartesian rates, contains `S:`). Numbers without sign and exponent, rounded up to µm/s: a rate read too high lowers `cap`, so the speed tends to stay below the top speed. A valid response is also accepted when late or as the response to another client's query: it shows the current values in any case.
- **Decision plausibility range:** X, Y, Z 60 … 10000 mm/min, A 60 … 36000 °/min (`RATE_MIN_UM_S`/`RATE_MAX_UM_S`). The range only catches garbage and misconfiguration, it does not limit the speed (see below). Lower bound: below 1 mm/s no axis is sensibly configured; the firmware defaults are at 3000 mm/min. Upper bound: 3.3 times the Z1 Pro (X/Y) or 10 times (Z, A); above that the resolution of `F` would be coarse (at 10000 mm/min one thousandth is 0.17 mm/s, the cap 119 or 29 thousandths). Invalid → next attempt after waiting time, jog gate stays closed.
- **Decision jog gate:** New rule 7a `!rates_known` → `NoRates` (display and web UI `Raten unbekannt` (rates unknown), 15 characters, fits in 21). After job (6) and alarm (7), so that the actual reason is shown there (no rates arrive in HALT), before 8/9, so the jog gate never opens without rates. `rates_known` applies to the axes of the selection: if A is missing from the response, only A stays locked. Second safeguard in the planner: without rates for the axis, every session is ended as in (a), and `feed_milli` returns 0 (no `F`, no command). The Z1 Pro test values (`z1_pro_rates()` in `test/test_core/test_suites.h`) are **only** test values; the firmware has no fallback value with which it could move without read rates.
- **Decision top speed:** Previously the upper limits were factors (`F_SCALE_XY/Z/A_MILLI = 1000/500/500`) and `F_MIN_MILLI = 20`; their absolute speed depended on the rate. Intended (#32, SPEC 8.7 "Honest assessment": "Z at most 5 mm/s"; examples "long and fast (20 mm/s)") at the rates assumed back then were: X/Y or XY path 1.000 × 20 = **20 mm/s**, Z 0.5 × 10 = **5 mm/s**, A 0.5 × 60 = **30 °/s**; lower bound 0.02 × rate = X/Y **0.4 mm/s**, Z **0.2 mm/s**, A **1.2 °/s**. These absolute values are now fixed in `core_config.h` (`JOG_MAX_SPEED_UM_S`, `JOG_MIN_SPEED_UM_S`), `F` is derived from them at runtime: `cap = min(1000, ⌊v_max × 1000 / rate⌋)`, `lo = min(cap, max(1, ⌈v_min × 1000 / rate⌉))`. **A higher machine rate never makes the handwheel faster than intended** (safety before comfort); `cap ≤ 1000` keeps `F` below the machine rate. A separate minimum speed per axis instead of a shared `F_MIN`, because a shared factor yields different minimum speeds at different rates (at the new rates, `F_MIN = 20` would have meant X/Y 1 mm/s: below 1 mm/s turning speed the machine would have moved faster than turned, and the stop-and-go from #32 would have returned in the "slow" range). With the old rates exactly the old limits result (test 93); the formula for `F` itself, `FEED_LEAD_PCT`, window, bundling and the e2 counting are unchanged.
- **Values for the Z1 Pro:**

  | Axis | Rate (read) | `F` limits old (#32) | absolute old at 3000/1000 mm/min | `F` limits new | absolute new |
  |---|---|---|---|---|---|
  | X, Y, XY (path) | 50 mm/s | 20 … 1000 | 1 … **50 mm/s** | 8 … 400 | 0.4 … 20 mm/s |
  | Z | 16.667 mm/s | 20 … 500 | 0.33 … **8.3 mm/s** | 12 … 299 | 0.2 … 4.98 mm/s |
  | A | 30 °/s (`M203.1`; file: 60 °/s) | 20 … 500 | 0.6 … 15 °/s (at 30 °/s) | 40 … 1000 | 1.2 … 30 °/s |

  Z is at 299 instead of 300 because `M203.1` reports 16.6667 (rounded up 16667 µm/s) and `0.300 × 16.6667 = 5.00001 mm/s` would be just above 5 mm/s; rounded down it stays below (4.98 mm/s). The XY logic stays correct: the firmware takes the smaller rate of X and Y and applies `F` to the path, hence `cap` from `min(rate_X, rate_Y)` and the path top speed 20 mm/s (14.1 mm/s per axis).
- **Observed response** (addendum 2026-11-11, coordinator at the machine, firmware 1.1.3.0.1.13, `M203.1` as `0xA2` frame): seven `0x90` frames `' X: 50 '`, `' Y: 50 '`, `' Z: 16.6667 '`, `' A: 30 '`, `' B: 1.66667 '`, `'\r\n'`, `'ok\r\n'`, i.e. one line ` X: 50  Y: 50  Z: 16.6667  A: 30  B: 1.66667 ` across several frames, end of line in its own frame. The existing path (`frame::Decoder` → `TextLines`, which collects across frames up to `\n` and discards `\r` → `parse_rate_line`, which skips leading and double spaces) handles this without change; test 97 feeds exactly these payloads (also byte by byte and with a status frame in between). **A is 30 °/s on this machine**, not 60 as in the file: the firmware caps A (`Robot.cpp` l. 295–299, 1800 mm/min). With a fixed value from the file the handwheel would have moved A twice too slowly with `F = v × 0.92 / 60`; read at runtime it is correct. A: `cap = min(1000, 30000 × 1000 / 30000) = 1000 = F_MAX_MILLI`, so the top speed 30 °/s is exactly the machine rate, `lo = 40` (1.2 °/s). The distance of A stays limited by the window (`WINDOW_UM[3] = 2000` mdeg, overrun at most 2.01°) and the direction lock, independent of the speed. `z1_pro_rates()` in the tests keeps A = 60 °/s (file value), so that the existing A tests are checked with both rates; test 97 covers 30 °/s.
- **Overrun examples (SPEC 8.7):** unchanged, because the absolute speeds and `FEED_LEAD_PCT` stay the same (at 5 mm/s about 1.6 mm in 0.4 s; 1 mm/s about 1 mm in 1.1 s; long and fast 20 mm/s 5 mm in 0.3 s). With the wrong rate they did not hold on the real machine (it moved faster than turned).
- **Status JSON:** The read rates are not in `/status.json` (not needed; test 67 and `WEB_JSON_MAX` stay unchanged). They are visible on serial (`Raten: …` (Rates: …)), the lock reason `Raten unbekannt` also in the web UI.
- **Residual risks:**
  - **Rates change during the connection** (`M203.1 X…` from Studio/MDI, configuration reloaded). Narrowed (review): the handwheel re-reads the rates every `RATE_REFRESH_MS = 30000` as long as the machine reports Idle, no alarm and no handwheel session is running and no query is in flight. A valid response replaces the rates; an invalid or missing one leaves the old valid ones in place (the jog gate does not lock because of a failed re-read; on serial once `Raten: erneutes Lesen ohne Antwort, alte Raten bleiben` (rates: re-read without response, old rates kept) or `Raten: Antwort verworfen` (rates: response discarded)). The planner never switches rates within a session, only between sessions (`JogPlanner::set_rates`; only rates that no longer cover the axis apply immediately and end the session). Residual risk: at most about 30 s plus one session with old rates; then only the ratio of turning to travel speed is off (if the rate rises, the machine moves up to `cap / 1000 ×` the new rate, so faster than 20 mm/s is possible; if it drops, slower). The distance stays limited by window and direction lock. Why 30 s: a query costs the machine almost nothing, but each one appears with `ok` in the console of other clients (Studio); 30 s is shorter than any realistic sequence "change rate, reach for the handwheel", and one line every 30 s is tolerable in the console (test 99). **Check:** taking over a changed rate and behavior on a failed re-read are checked only by test 99; no setting is changed on the machine for this (user decision), H-20 (f2) only observes that re-reading happens about every 30 s.
  - The response format has been observed on the machine (see above). If a later firmware changes it, the jog gate stays closed (`Raten unbekannt`, serial `Raten: Antwort verworfen: …`); that is safe, but the handwheel then does not move. If needed, adapt the parser (separate ticket), do not bypass the lock.
  - The response to `M203.1` and the `ok` also appear in the console of other clients (Studio), once per connect and every 30 s while idle.
  - After an alarm the first query goes out with the first status without alarm (review); until the response, `Raten unbekannt` is shown.
- **Unchanged:** rules 1–10 of the jog gate, session start, direction lock, window, bundling, queue upper limit (`JOG_MAX_QUEUED`), `FEED_LEAD_PCT`, speed measurement. Tests 93–99, adapted 30–47, 55, 57, 76–89 (new `F` values at the Z1 Pro rates).

## 2026-11-11 · A axis only with "Drehachse A vorhanden" (rotary axis A present), A module can be hidden, wider map (ticket #39)

- **Finding:** "Drehachse A: aus" (rotary axis A: off), yet status page and 3D view showed A (WPos −90.000°, MPos 0.000). The machine always reports five position values, so `has_a` is always true.
- **Decision:** A (row in the position, disc in 2D, module and chip in 3D) only with `axis_a_enabled && has_a`. The setting is already in `/status.json`, nothing changes in firmware and JSON. Without status A is likewise hidden (like the tool marker).
- **Decision switch:** "A-Modul" (A module) (title "A-Modul anzeigen" (show A module)) to the left of "Ansicht zurücksetzen" (reset view), only visible when A is shown; default on, remembered per browser (`localStorage.a3 = '0'` for off, `try/catch`). It only hides the geometry (which covers the spoilboard), the chip with the angle stays; the notice "Lage der Drehachse geschätzt" is dropped when the module is hidden.
- **Decision chip:** Like the position display: WPos angle bold, machine angle small, three decimal places with comma ("A −90,000° · Maschine 0,000°" (A −90.000° · machine 0.000°)). The rotation of the stock still follows the MPos.
- **Decision desktop grid (user request, added to the ticket afterwards):** From 900 px columns 3 : 2, on the left the position map across all rows, on the right stacked state, position, connection, handwheel, link statistics (previously 1.6 : 1 : 1 with connection and handwheel side by side). The last row is `1fr`, so that the tall card does not push gaps between the right cards. 3D area 70 vh high (at least 24 rem) instead of square, 2D map at most 70 vh. Width at most 92 rem (1472 px) instead of 74 rem; header row equally wide. Threshold stays 900 px instead of the proposed about 1024 px: between 900 and 1024 px the right column at about 340 px is still wide enough, and a second threshold would have cost page size. Phone (single column) unchanged.
- **Size:** Status page 13,618 → 13,784 bytes (target below 14,336 bytes), 3D module 5,343 → 5,903 bytes gzip, assets together 178,654 bytes.
- **Check:** Mock `/status.json` with `has_a = true` and `axis_a_enabled` off/on, also switching at runtime, in Chromium at 390, 1280 and 1600 px, light and dark, without console messages. On the device: H-19 (f), (g).

## 2026-11-11 · Spoilboard position measured (ticket #40)

- **Measurement (user, 2026-11-11):** In Makera Studio moved to "QuickMove → Anchor1", MPos X −191.580 / Y −194.140 (= `coordinate.anchor1_x/y`). The stop square rests exactly against the front left spoilboard corner, both legs 15 mm wide: anchor 1 lies 15.0 mm from the left and 15.0 mm from the front spoilboard edge.
- **Decision:** Corner = anchor 1 − (15, 15) = MPos −206.580/−209.140 mm → `UI_BOARD_ORIGIN_MPOS_X_UM = -206580`, `UI_BOARD_ORIGIN_MPOS_Y_UM = -209140`, `UI_POS_CALIBRATED = true`; the notice "Plattenlage geschätzt" is dropped. The old estimate (−207,000/−206,000, corner = travel minimum) deviated by +0.42 mm in X and −3.14 mm in Y. The spoilboard thus projects 3.14 mm in front of the Y minimum of the travel (−206 mm), plausible: the tool does not have to reach the front spoilboard edge. 2D map and 3D view already take the union of spoilboard and travel as the viewport; no code change needed.
- **Decision spoilboard height:** `UI_BOARD_TOP_MPOS_Z_UM` stays estimated (−102 mm), `UI_POS_CALIBRATED` applies only to X/Y. No separate notice on the page: the MPos Z depends on the tool length, a fixed value remains an approximation per tool even when measured; a notice would cost bytes of the status page (target below 14,336 bytes) for a figure that never becomes exact. Documented in `ui_config.h` and SPEC 9.1.
- **Size:** Status page unchanged at 13,784 bytes (dynamic beginning of equal length), web assets unchanged.
- **Check:** `tools/dump_web_pages.cpp` with mock `/status.json` (MPos −191.580/−194.140) in Chromium, 2D and 3D: crosshair 15/15 mm from the front left spoilboard corner, spoilboard visibly projects in front of the travel. On the device: H-18 (d), cross-check via holes.

## 2026-11-11 · Unlock after alarm at the handwheel (ticket #41)

- **Trigger:** When the machine is in alarm/HALT (endstop, `Ctrl-X`, abort), Studio previously had to unlock it. Model: unlock dialog in Makera Studio or CarveraController (`Controller.unlock()` sends `$X`, `Controller.py` l. 1041–1046).
- **Decision (coordinator/user):** Unlock at the handwheel by holding an axis button (X, Y, Z; A only with `axis_a`) continuously for **5 s** (`UNLOCK_HOLD_MS = 5000`; the user changed 2 s to 5 s) while the machine reports alarm. Independent of the alarm reason: no list of allowed reasons, no "homing required" lock. Never automatic, never by the wheel, never by the web UI (it stays read-only; "The web UI never talks to the machine" stays true). The press edge still selects the axis; the hold is added. Exactly one `$X` per hold, additionally at most one per `UNLOCK_MIN_INTERVAL_MS = 2000`.
- **Firmware finding** (v1.1.3, read only): `0xA2` (`PTYPE_CTRL_MULTI`, `PublicData.h` l. 15) → `ON_CONSOLE_LINE_RECEIVED` (`SerialConsole.cpp` l. 190–201), without halt filter. `GcodeDispatch.cpp` l. 74–76 skips `$…`; `SimpleShell.cpp` l. 329 accepts `$…`, l. 347–351: `$X` lifts the HALT only when `is_halted()` and outputs `[Caution: Unlocked]\nok\n` (one `printf` → one `0x90` frame, `SerialConsole.cpp` l. 473–491). Without HALT there is no response. `Kernel.cpp` l. 754–772: lifting resets the position from the motor positions (`reset_position_from_current_actuator_position`). `Conveyor.cpp` l. 87–92: on HALT the motion queue is flushed, so after `$X` no old block remains in the machine. `Alarm` in the status is exactly `halted` (`Kernel.cpp` l. 291–292), `H:` is present then (l. 525). `Ctrl-X` reports `HALTED, M999 or $X to exit HALT state` (`SerialConsole.cpp` l. 519). CarveraController frames `$X` exactly like the handwheel frames `M203.1`/`$J`: `0xA2`, without `\n` (`Controller.py` l. 284–315, 370–377, 1008–1009). It is checked on the machine with H-21.
- **Decision start only with an edge:** A level alone never starts. So a button that was already pressed before the alarm only counts after release and a new press; if a condition drops away, timing only starts again with a new press; and an edge swallowed by the screensaver (`edges = 0`) cannot start a hold. The hold belongs to the button that started it (X released, Y still held → abort), so that "held continuously" applies literally.
- **Decision freshness:** the same limit as gate rule 4 (`SEND_MAX_AGE_MS = 250`), no new constant, no relaxation.
- **Decision OTA/AppMode:** `ota::updating()` (new, read only) and `mode == Normal` enter as conditions, although no tick runs during an OTA transfer and outside Normal: second safeguard in case that changes.
- **Decision session end on sending:** When sending `$X`, `main.cpp` calls `planner.end_session(now)` and `accumulator.clear()`. Checked: detents from the alarm and from the hold already expire with the existing logic (gate locks, `accumulator.clear()` per locked tick, no session, no `pending`). There was a gap at session start: without a preceding session end (e.g. connected in HALT, no alarm line received) an Idle a few ms after the `$X` with one detent would have started a session immediately (8.7 c.3: "never ended" counts as fulfilled). With `end_session` on sending, c.3 applies from the `$X`: only an Idle received at least `START_GAP_MS` afterwards and new turning start a session. This only tightens (test 106 fails without the call); gate, planner and window are unchanged.
- **Decision display:** At the bottom `Entsperren: Taste 5 s` (Unlock: button 5 s) (exactly 21 characters), for which the unit is dropped; in alarm nothing moves, the unit is dispensable there, and with the unit only about 18 characters would fit. The hint replaces the lock reason, which in alarm without a selected axis would read `Achse wählen` (select axis) (rule 5 before 7) and was thus misleading anyway. An alarm/error line keeps its 2 s precedence; during this time the hint is not visible, so no hold begins (`hint_visible`). During the hold `Entsperren` (unlock) with a bar, afterwards `Entsperren...` (unlocking...) until the first status without alarm, at most `UNLOCK_SHOW_MS = 2000` (in `core_config.h` like `ALARM_SHOW_MS`, because `lib/core` evaluates it). The texts state "5 s" as a fixed value; a `static_assert(UNLOCK_HOLD_MS == 5000)` in `main.cpp` keeps them consistent. LEDs unchanged (selected axis blinks, gate locked).
- **Decision web UI:** No new JSON field and no new page text: `web_snapshot` sets the lock reason to `Alarm, Taste 5 s: Entsperren` (alarm, button 5 s: unlock) or `Entsperren...`; the page colors everything beginning with `Al` red (`/^Al/.test(d.gate)` instead of `d.gate=='Alarm'`, +3 bytes, status page 13,787 of 14,336 bytes). Worst case of test 67 now with this longest lock reason. Read only.
- **Decision screensaver:** Unchanged. The alarm wakes as attention without a wake window, so the hint is visible and the next edge counts. If the display has fallen asleep again during a long-lasting alarm, the waking edge is swallowed like any other; only a new press unlocks (consistent with 10.4).
- **`RateQuery`:** The response lines `[Caution: Unlocked]` and `ok` are `NotRates` for `parse_rate_line` (they do not begin with `X:`), without effect on schedule, error counter and rates in all phases; they do not begin with `ALARM`/`error`, so they are not an alarm line (test 107). In alarm no query is made anyway (8.8).
- **Residual risks:**
  - `$X` lifts the HALT regardless of the reason, also after an endstop alarm or without homing; the machine takes the position from the motor positions. Deliberate decision of the user, as in Studio. The handwheel afterwards only moves on new turning with all rules (8.5–8.7); moving further into the same endstop triggers an alarm again.
  - Axis selection: the press edge of the held button acts like any press on the `AxisSelector` (8.4): it selects the axis, deselects an already selected one (X or Y with X or Y selected), forms XY with another selected axis (Y with X, X with Y), or for Z/A deselects everything else. After unlocking, the state that this press produces is therefore selected; whoever then turns moves it. LED and display show this. Intended: the axis selection stays unchanged (specification), and the jog gate applies afterwards as always.
  - If `$X` does not reach the machine (buffered, Wi-Fi), it stays in alarm; after `UNLOCK_SHOW_MS` the hint appears again, a new hold sends again.
  - Other clients see `[Caution: Unlocked]`/`ok` in their console (the Wi-Fi module mirrors everything).
- **Check:** Tests 100–107; on the machine H-21.
- **Review addendum (2026-11-11):**
  - **A status gap during the hold no longer aborts.** A fresh status (≤ `SEND_MAX_AGE_MS`) with alarm is mandatory at the start (edge) and in the tick of sending. If the status becomes stale in between, the hold continues; if it is stale when the 5 s are reached, the handwheel waits (bar at 999 ‰, full only on sending) and sends with the next fresh alarm status as long as the button is held, at most until `LINK_STATUS_TIMEOUT_MS` after the last status (then disconnect, abort `keine Verbindung` (no connection)). Abort still on: button released, offline, no status, **fresh** status without alarm, OTA, other operating mode, new alarm/error line. Rationale: `$X` moves nothing, freshness at sending is retained; it is only about operation during Wi-Fi stalls (status gaps up to 430 ms on the real Z1, 8.7 a0), with which a 5 s hold would otherwise fail. A stale status without alarm does not abort, but never sends (tests 108).
  - **A new alarm/error line aborts the hold** (`Entsperren: abgebrochen (neue Meldung)` (unlock: aborted (new message)), `alarm_ms()` has changed since the last tick): the user should first see a new event before unlocking; the line then has 2 s precedence, only after that does a new press count (test 109). Residual risk: error lines that the Wi-Fi module mirrors from other clients (Studio) abort as well; H-21 (i) observes this.
  - **Web UI:** during the hold `Alarm, Entsperren läuft` (alarm, unlock in progress) (only `/status.json`, status page unchanged at 13,787 bytes).

## 2026-11-11 · Enclosure: antenna recess for the ordered PCB antenna 50 × 15 (ticket #44)

- **Question:** The ordered antenna (sourcing map, Amazon B0816WKB5V, 5 dBi, u.FL) is a rigid PCB adhesive antenna **50 × 15 mm** with RF1.13 cable **195 mm**, not the assumed FPC antenna ~40 × 10 with ~10 cm cable. The 46 × 12 recess is too small. Where and how large?
- **Decision:** Recess **51 × 16 × 0.3** (0.5 clearance per side), free area **55 × 19** (margin 2 at the sides, 1.5 at top and bottom), both **centered at x 46** (enclosure center, instead of 55), z 25 unchanged. Recess x 20.5…71.5, z 17…33; antenna x 21…71, z 17.5…32.5; free area x 18.5…73.5, z 15.5…34.5. Dimensions as `ANT_SIZE`, `ANT_CLEAR`, `ANT_MARGIN` in `make_enclosure.py`, recess and area computed from them.
- **Rationale for the position:**
  - With center x 55 the free area reached up to x 82.5 and would hit the boss at the top right (Ø 8, x 80…88, y 4…12, stands 1.5 in front of the inner wall surface, the placeholder is 3 deep). So shift it. The inner wall is straight between the corner radii x 10…82.
  - x 46 places the antenna centered between both heat-set inserts (x 8 and 84, outer Ø ≈ 5): **≈ 10.5 mm** clearance each, which keeps the recommendation ≥ 10 mm to metal. With the smallest shift (center 52.5, area up to x 80) only ≈ 4 mm would remain to the right insert.
  - z 25 stays: the free area ends 1.3 above the rabbet (z 14.2; the lip of the bottom tray reaches up to z 14) and 2.5 below the front plate (inside z 37), the antenna lies entirely in the front shell (z 12…40). Further down would only be possible at the expense of the distance to the rabbet.
  - Display: the module board (x 28.3…63.7, y ≥ 10, z ≥ 34.3) lies diagonally in front of the antenna as before, ≈ 7.5 mm (y 7.3, z 1.8). In x it now lies entirely within the antenna length; the distance does not change, because the old position overlapped in x as well. Handwheel and battery stay far away (y ≥ 81).
  - Remaining wall at the recess 2.5 − 0.3 = **2.2 mm** (≥ 1.2). Nothing lies on the outside of the upper end wall (grip grooves only in the long walls, edge chamfer only from z 38.5).
- **Cable 195 mm:** The direct route from the cable exit to the u.FL at the right end of the FireBeetle (x ≈ 60, top side z ≈ 24.5, y ≥ 19.3) is only 2…5 cm long; ≈ 15 cm is excess length. The excess length helps during assembly (front shell lies next to the bottom tray while the u.FL is plugged in). Stowage: a loose, flat loop (oval about 45 × 12, bending radius ≥ 6 mm) in the free space between end wall and FireBeetle, y ≈ 6…18, x ≈ 14…64, z ≈ 9…14: on the free margin of the carrier board (y 12…19.3, on top only the mounting holes; R3–R5 sit on the underside) and in front of it. Nothing lies there in the placeholder model; connectors J1/J2 only from x 66, bosses and screws at x ≤ 12 and ≥ 80. Do not lay it over the antenna area (cable in the near field), keep at least 3 mm away from the end wall so that it does not get caught between lip and rabbet when closing. **No holder:** the cable stays in the loose loop by itself; if needed, a strip of Kapton tape on the board. A printed holder would need a fixed cable position, which only the trial assembly will show.
- **Check:** Volume change of the front shell −79.2 mm³, computed (51 · 16 − 46 · 12) · 0.3 = 79.2. Bottom tray unchanged (STL byte-identical except for the name in the header). Collision check of the placeholders see README. Whether the antenna is sufficient in the closed enclosure is still checked by H-15 (e).

## 2026-11-11 · Makera logo optional, neutral replacement "MPG" (ticket #45)

- **Question:** The repository is to become public. The Makera logo (screensaver `src/logo_bitmap.h`, enclosure engraving `hardware/enclosure/logo_polygons.json`) is a trademark of Makera and must not be included. How does the private version remain usable locally without build, CI and the checked-in print data depending on it?
- **Decision:** Both logo files are **git-ignored** and removed from the repository; they are created locally with the tools, which may stay (no logo in them): `python3 -I tools/logo_to_xbm.py <logo.png> src/logo_bitmap.h` and `python3 -I hardware/enclosure/trace_logo.py <logo.png>`. Without the file a neutral replacement applies, with the file everything is as before. Supersedes the rule "remove before publication" from the entries of 2026-11-10 (ticket #28, #30). **Superseded by #50:** both files are committed in the private repository and left out of the public export; the fallbacks stay for the export.
- **Screensaver:** `display.cpp` selects via `__has_include("logo_bitmap.h")`, otherwise `src/logo_fallback.h` (checked in): own pixel lettering **"MPG"** (Manual Pulse Generator, generic term), 40 × 32 px, 160 bytes, strokes 3 px, letters 12 px wide with 2 px spacing. Same names (`LOGO_W`, `LOGO_H`, `LOGO_XBM`) and size as the logo, hence the same random position, jumps every `SAVER_MOVE_MS` and the same burn-in protection; `lib/core` is untouched. A `static_assert` checks that the image fits on the display and that the data length matches `LOGO_W × LOGO_H`. Chosen instead of a font drawn at runtime: no second drawing path, and the image can be viewed as ASCII in the header like the logo. CI builds without logo, so always the replacement.
- **Enclosure:** Without `logo_polygons.json`, `make_enclosure.py` engraves **"MPG" entirely in Helvetica bold**, same cap height 14, baseline, center x 46 / y 57 and depth 0.6; centered by the measured ink (1.434…42.997 at height 14, width ≈ 41.6 instead of ≈ 44). Remaining plate 2.4 mm (≥ 1.2). With the local file, `enclosure.json` stays byte-identical to the logo version. The **checked-in** outputs (`enclosure.json`, `handrad_enclosure.sc`, `enclosure.step`, `front_shell.stl`, `enclosure_front.png`, `enclosure_iso.png`) show the neutral version, rebuilt with `solidcraft-cli`; `bottom_tray.stl`, `assembly_check.json` and the other images (no engraving in the image) are unchanged. Front shell 82,348.2 mm³ (+8.6 compared with the logo version).
- **Docs:** `hardware/enclosure/README.md` is now in English (user request, like `hardware/README.md`), with a notice at the top: logo not included, trademark of Makera, no affiliation with Makera, how to create your own version locally. The German notice for the screensaver is in SPEC 10.4.
- **Residual risk:** The **Git history** still contains the logo (`src/logo_bitmap.h`, `logo_polygons.json` and the old STL/STEP/`.sc`/PNG up to ticket #44). Before a publication, clean up the history or create the repository anew without history; that is not part of this ticket. **Superseded by #46/#50:** the public repository is a fresh export without history, the logo is not included.

## 2026-11-11 · Rotary axis module in the 3D view from Makera's CAD model (ticket #48)

- **Source:** `Makera-Z1_Simplified_4Axis.step` from https://github.com/MakeraInc/CarveraProfiles/tree/main/Machine_Design_Files (Makera, public repository without a licence), downloaded 2026-11-11 via `raw.githubusercontent.com` (no Git LFS; 5,346,017 bytes, git blob `6a77fd11d6549d4940bada447eee6431721d5f96` = the blob GitHub lists, SHA-256 `b7df28bc…8dfd12`, STEP header time stamp 2026-07-23). Without a licence the file is **not** committed (**superseded by #50:** committed in the private repository, left out of the public export): it lives git-ignored in `hardware/vendor/a_axis/`, only the derived, simplified dimensions are in the repo (`include/a_axis_geometry.h`, with source note), like the spoilboard (ticket #36). The file is treated as untrusted: `tools/make_a_axis_geometry.py` is an own text parser (no CAD package), run isolated with `python3 -I tools/make_a_axis_geometry.py <STEP> > include/a_axis_geometry.h`, nothing from the vendor folder is executed.
- **Model:** an assembly of the whole Z1 with, below the occurrence "Y Axis" (the moving table), the spoilboard `Z1-MDF-v2.1`, the anchor plate `Anchor1`, the module `4th Axis` (rail `MZ1--V20003`, headstock `MZ1--V20005`, motor bracket and cover `MZ1--V30002`/`V30001`, `Spindle Chuck` with four jaws, `Tailstock`) and a `Toolsetter` without geometry. The script applies all occurrence transformations (`ITEM_DEFINED_TRANSFORMATION`: placement 1 of the child onto placement 2 of the parent) and checks that board, anchor plate and module hang below the same assembly, so the pose of the machine axes in the model does not matter. Cross-check: the 54 holes of the board in the assembly match `include/spoilboard_geometry.h` (from the separate `Makera-Z1_MDF-v2.1.STEP`) position by position, i.e. same orientation, not mirrored.
- **Registration chain:** model → board-local → MPos. (1) In the model the spoilboard is 206 × 206 × 6 mm, its front left corner (smallest x, y) is the origin of `a_axis_geometry.h`, its top is the height reference, exactly as `spoilboard_geometry.h`. (2) The origin of the part `Anchor1` (= anchor 1) lies **15.00/15.00 mm** inside that corner in the model, the same value the user measured on the machine (ticket #40); the script aborts if this differs by more than 0.05 mm. (3) The page places the corner at the measured MPos (`UI_BOARD_ORIGIN_MPOS_{X,Y}_UM` = −206.580/−209.140) and the board top at `UI_BOARD_TOP_MPOS_Z_UM` (−102, still estimated). So the module needs no MPos constants of its own: `UI_A_AXIS_MPOS_X/Y_UM` and `UI_A_AXIS_HEIGHT_UM` and the fields `ax/ay/ah` of `C` are removed, `UI_A_POS_CALIBRATED` stays.
- **Derived values** (board-local → MPos with the measured corner): rotation axis parallel to X (all chuck circles and the live centre coaxial, normals ∥ X), **y 93.26 mm → MPos Y −115.88 mm**, **45.00 mm above the board top → MPos Z −57.00 mm** (with the estimated board top). Along X: motor housing back −42.76 → −249.34, rail −24.45 … 237.55 → −231.03 … +30.97 (52 × 8.5 mm profile lying on the board, it overhangs the 206 mm board on both sides), headstock block 10.24 front face → −196.34, chuck body Ø 48.7 10.24 … 43.24 → −196.34 … −163.34 (ring Ø 52 16.74 … 30.74), jaws 25.74 … 57.14 → −180.84 … −149.44 (radially 6.2 … 31.7 mm closed, 10 mm wide), live centre tip 190.43 → −16.15, tailstock body 205.35 … 224.35 → −1.23 … +17.77. Headstock and tailstock are T profiles: upright 35 mm wide up to 17.5 mm above the axis, foot 52 mm wide on the rail. Motor housing: back box x −42.76 … −24.76, 71 mm in front of to 21 mm behind the axis, 4 … 66 mm above the board; front block x −24.76 … 15.24, 28 … 71 mm in front of the axis, 4 … 46 mm above the board.
- **Comparison with the placeholder (ticket #37) and the machine config:** placeholder axis Y −125.14 (anchor 1 + `rotation_offset_y` 69.0), CAD −115.88: **the CAD axis lies 9.26 mm further back**. Placeholder height 30 mm, CAD **45 mm** (+15 mm). In X the config fits the CAD: anchor 1 + `rotation_offset_x` = −199.08 lies 2.74 mm behind the headstock front face, and the firmware's Z probing points (reference −3/−7 mm, `ATCHandler.cpp`) land on the top of the headstock block, which in the CAD is 17.5 mm above the axis (config `rotation_offset_z` = 17.0, the WCS Z on the probe surface relative to the chuck centre). So `rotation_offset_x/z` describe a probe point on the headstock top, not the chuck face (ticket #37 assumed "chuck face"). The Y difference is open: either the module in the CAD is not placed exactly where it is mounted, or `rotation_offset_y` is only the Y of the probe point on the 52 mm wide headstock top and not the axis. **Decision:** the view follows the CAD consistently (it is the only source for shape, height and position in one frame, and its registration to the board is exact); `UI_A_POS_CALIBRATED = false` and the chip says "Lage der Drehachse aus CAD" instead of "geschätzt". H-22 checks Y, height and X on the machine; if Y matches −125.14, a follow-up ticket shifts the module (one value in the generator) and sets the flag.
- **Simplification:** 7 boxes (rail, headstock upright and foot, motor housing back and front block, tailstock upright and foot), 2 chuck cylinders, 4 jaws, quill Ø 15 with live centre cone; the generator derives them from the parts (bounding boxes, T split at half height, circles on the axis), no hand-entered dimensions. The stock is not in the model: Ø 30 mm (not 40 as in the placeholder: with the chuck Ø 48.7 a Ø 40 stock would hide the chuck) from the back of the jaws to the live centre tip (164.7 mm); the jaws are drawn opened to the stock (radially shifted, CAD shape), their angle is the CAD pose (1°, chuck turned by 1.4° in the model; the real angle at A = 0 is unknown anyway). The tailstock slides on the rail on the machine; the view draws it at the CAD position. The module reaches 42.8 mm left of the board (motor housing); the initial camera view is unchanged (board and travel), the module may be cut at the left edge until the user pans.
- **Size:** `A_AXIS_JS` (316 bytes with the variable `G`) is spliced into the flash part of the status page like `SPOILBOARD_JS` and passed to the 3D module as fourth argument. Status page 13,787 → **14,072 bytes** (dynamic head 214 → 183, flash part 13,573 → 13,889; target below 14,336 bytes). 3D module 5,903 → 6,134 bytes gzip, assets together 178,885 bytes.
- **Check:** generator run (all internal checks pass, anchor 15.00/15.00), hole cross-check against `spoilboard_geometry.h`, page rendered with `tools/dump_web_pages.cpp`, a mock `/status.json` (A enabled, MPos A 30°) and headless Chromium at 1280 px light and dark and 390 px: module, chip "A 30,000° · Maschine 30,000°, Lage der Drehachse aus CAD", no console errors. On the machine: H-22 (new), H-19 (d) refers to it.

## 2026-11-11 · Soft power: on/off button as an input, battery always on the charger (ticket #49, user decision)

- **Question:** The latching power button sat in the battery's positive lead (J2) in front of the FireBeetle's "Li-ion +" pad. Charger and board supply share that pad, so with the button off the battery was disconnected and did not charge. How can the battery charge with the handwheel switched off?
- **Decision (user):** Soft power. The battery is permanently connected (J1 → pogo P1/P2 → "Li-ion +/−"), the button becomes an input; off = deep sleep.
- **Rejected:**
  - *Schottky diode from the charger output past the switch:* about 0.3 V loss, the battery would only charge to about 3.9 V (≈ 70 % capacity), and the battery reading would be wrong by the diode drop (measurement on the wrong side).
  - *Button on the ESP32's EN (RST) pin:* holding the chip in reset leaves the 3V3 rail on, so the display (same rail) keeps its last frame lit; the switch sense would be inverted (closed = off); and the ESP32 would be cut off without ending the jog session or closing the socket.
- **Decision (implementation):**
  - **GPIO4 (D12, top row pin 12)**, RTC-capable, ext0 wake, internal pull-up, no strapping pin. First GPIO15 (A4) was chosen; with the re-layout (see "Connector rows" below) the on/off connector moved to the right end of the upper row, which only the outermost lane on the right reaches without crossings, and that is top pin 12. Rejected for the button: GPIO0 (LOW at reset = download mode, the handwheel would never start with the button on), GPIO2 (must be LOW/floating for flashing, drives the on-board LED), GPIO12 (HIGH at reset = 1.8 V flash, brick risk with any pull-up), GPIO15 (strapping, now LED Z).
  - **Internal pull-up**, no external 10 kΩ: the RTC pull-up stays active in deep sleep with ext0, the button only matters with an open contact (no current when off), and on one layer there is no 3V3 near the route. Noise: polling with 100 ms debounce, cable of about 10 cm. If H-23 shows spurious off events, a 10 kΩ 0805 to 3V3 is the fallback (parts on hand; needs a route).
  - **Sense:** closed = LOW = on (`POWER_SW_ACTIVE_LOW`). A missing or broken cable reads "off" (fail-safe: the handwheel sleeps).
  - **Connector rows (user requirement, re-layout of the board):** FireBeetle, outline 78 × 66 mm and the four holes unchanged. Lower row (next to the board edge towards the axis buttons): J9 X, J8 Y, J5 Z, J7 A from left to right, like the buttons at x 16/36/56/76 in the enclosure. Upper row: J4 display and J6 handwheel on the left, J2 on/off at the right end, where the button in the right enclosure wall is (the old J7 position). Buttons in the edge row: their leads are the shortest and come from below; the display cable comes from above; the wheel cable runs over the battery and the button plugs anyway. J1 (user request) sits directly above J2 at the right edge (pin 1 at x 66.0, y 31.5): battery and on/off cables both go to the right side of the enclosure, and the battery tracks just run further down the right edge. Left of J2 in the upper row is impossible (the lanes on the right come down there); in the rows the battery lines would have to cross those lanes. Enclosure: free space there, no change needed; the placeholder `P_JST_J1J2` still marks the old place (hardware/README.md).
  - **Pin map rev 2** (crossing-free on one layer; every source must land in the same order as the connectors): buttons X 13 (D7), Y 26 (D3) with internal pull-ups, Z 35 (A3), A 36 (A0) with 10 kΩ; LEDs X 14 (D6), Y 25 (D2), Z 15 (A4), A 12 (D13); on/off 4 (D12); GPIO39 unused, R3 dropped. The bottom-row pins feed X and Y straight down, the lanes on the right (top pins 6, 7, 10, 11, 12, inner to outer) feed Z, A and J2. Only two outputs come from the lanes, so the strapping pins GPIO15 and GPIO12 drive LEDs: an LED to GND can only pull them LOW at reset, which is the safe state for both (GPIO12: internal reset pull-down plus LED = LOW = 3.3 V flash; GPIO15: internal reset pull-up against the LED, either level harmless, LOW only silences the ROM log). In deep sleep they get an RTC pull-down under the hold. The handwheel's 0V comes from FireBeetle bottom pin 4 (net `GND_ENC`), because a GND path from below would cross the X/Y lines.
  - **Labels:** connector names 1.2 mm, pin names 0.8 mm (the earlier renders were unreadable); `export.sh` also writes `fab/handrad-top.png` (top render) and `fab/handrad-top-labels.svg` (2D top view).
  - DRC: no errors, no unconnected items (only the three known silkscreen warnings at J1). No new parts (one 10 kΩ fewer).
  - **Firmware:** `PowerSwitch` (`lib/core/power_switch`, tests 110–112) debounces with `POWER_SW_DEBOUNCE_MS = 100` (longer than the axis buttons: an "off" costs a restart). Boot: at most `POWER_SW_BOOT_MAX_MS = 1000` for a stable level; off → sleep at once without Wi-Fi (USB, after flashing, after a reset); no stable level → normal start. Loop: first debounced off → `planner.end_session`, then `power::shutdown(SwitchOff)`: `machine::stop()` (orderly close), Wi-Fi off, wheel and LEDs off, display power save, RTC GPIOs isolated, ext0 wake on "on". The battery shutdown uses the same function (`BatteryEmpty`, message for 5 s first).
  - **Empty battery:** before, deep sleep without wake source and power-cycling by the switch. Now ext0 waits for the **opposite** level of the button: with the button on it wakes on "off", the boot sees "off" and sleeps waiting for "on"; switching on starts normally and measures the battery again (critical → asleep again). It never restarts by itself and needs off/on to retry, as before. With the button on, the RTC pull-up costs about 75 µA through the closed contact until the user switches off.
  - **OTA:** during the transfer the loop is blocked in `ArduinoOTA.handle()`, the button is not read. The transfer ends (success or error) with the usual restart, the boot finds the button off and sleeps. The machine socket is already closed at `onStart`. Aborting the transfer from the progress callback was rejected: it would add a second, rarely tested exit from the update, for at most about 30 s gained.
- **Residual risk:** "Off" is not a disconnect. The board draws about 0.5 mA asleep (H-5, target < 1 mA): a 3000 mAh battery lasts months; the battery's protection board cuts off at 3.0 V. For storage unplug J1. On USB the board can no longer be power-cycled with the button (it sleeps instead, which is enough to leave diagnostics).
- **Review addendum (fresh context):**
  - **Board revision guard:** NVS key `board_rev`, read before any output is configured (`board_rev_action`, `BoardRevConfirm`, tests 113–114, SPEC 9.2). Firmware for another revision would drive outputs into inputs of this board (e.g. a GPIO into a closed switch to GND). Safe mode drives nothing, shows "Falsche Firmware" and waits for the board button held 3 s (deliberate board change) or for the right firmware over USB. **No OTA in safe mode:** it needs Wi-Fi, mDNS, the web UI and the OTA acceptance rule, i.e. most of normal operation; the USB socket is reachable in the enclosure. After 10 min the chip sleeps without wake source (battery).
  - **Orderly close on power-off:** `machine::stop()` now calls `shutdown(SHUT_RDWR)` before closing, and `power::shutdown` waits `POWER_OFF_FLUSH_MS = 150` before `esp_wifi_stop()`, so the FIN reaches the machine instead of leaving a half-open connection. The session still ends first; no `$J` can follow.
  - **Pin orders:** Pin orders: J9 and J8 are G, G, SIG, LED; J5 is G, G, LED, SIG; J7 is SIG, LED, G, G. J5 cannot match J8/J9: of the lanes on the right only GPIO15 and GPIO12 can drive an LED (GPIO35/36 are input-only), LED Z must therefore be the inner lane GPIO15, and the lanes land on the connector pins in their order. J7 cannot match either: its last pin must be GND, because J2's GND drops straight onto it (any other GND path would cross the A lines).
- **Check:** Tests 110–114; on the device H-9, H-23, A-7, A-10.

## 2026-11-11 · Private files in the private repository, left out of the public export (ticket #50, user decision)

- **Question:** The Makera logo files and the vendor CAD files were git-ignored (tickets #31, #36, #45, #48), so they existed only in one local checkout: no backup, not in worktrees, not reproducible. The public version goes to GitHub as an export (ticket #46). Where do these files live?
- **Decision (user):** The private, self-hosted GitLab repository holds everything; only the public GitHub export leaves things out. Committed: `src/logo_bitmap.h` (2.9 KB), `hardware/enclosure/logo_polygons.json` (1.2 KB), `hardware/vendor/` (`DFR0654.step` 9.6 MB, `MODULE_DFR0654.kicad_mod`, `License.txt`, `enclosure/oled_1p3.step` 2.2 MB, `enclosure/button_12mm.step` 1.0 MB, `enclosure/zss600.step` 1.0 MB, `spoilboard/Makera-Z1_MDF-v2.1.STEP` 0.26 MB, `a_axis/Makera-Z1_Simplified_4Axis.step` 5.3 MB, `README.md` with sources, dates, licences and SHA-256), `hardware/handrad_pcb/fab/handrad.step` (8.3 MB) and `hardware/enclosure/handrad_assembly.sc` (5.8 MB). About 33 MB in total, largest file 9.6 MB: no Git LFS (no file near the 50 MB limit).
- **Licences:** DFRobot/SnapMagic DFR0654 (`hardware/vendor/License.txt`): use in own board designs is allowed, the models themselves must not be distributed or made available to third parties. A private, self-hosted repository for own use is no distribution, so the files may live there, but they are **never exported**. Makera STEP files: public repository without a licence, i.e. all rights reserved; a private copy for own use only, never exported. Makera logo: trademark, private use only (tickets #28, #45). Enclosure part models (OLED, button, handwheel): licence unknown, treated the same way.
- **Deny-list:** `tools/strip_private.py` has `PRIVATE_FILES` (exact paths, an entry ending in `/` covers a folder): the two logo files, the local logo builds of the enclosure (see below), `hardware/vendor/`, `fab/handrad.step`, `handrad_assembly.sc`. They are skipped when copying (and in the marker check); `--list-private` prints the list. CI job `public-export` additionally checks that the private files exist in the private tree, that none of the listed paths exists in the stripped tree, and, independent of the list, that no `hardware/vendor`, `logo_bitmap.h`, `logo_polygons.json`, `handrad.step` or `handrad_assembly.sc` is found there; the stripped tree still runs the native tests and builds `firebeetle` with the neutral "MPG" (`__has_include` fallback). The derived headers `include/spoilboard_geometry.h` and `include/a_axis_geometry.h` stay in the export (own dimensions, as decided in tickets #36 and #48). The export must stay a copy without Git history (tickets #46, #49): the private history now contains all these files.
- **Enclosure outputs stay neutral:** The committed `front_shell.stl`, `enclosure.step`, `handrad_enclosure.sc`, `enclosure.json` and renderings are what the export ships, and `strip_private.py` only leaves files out, it does not swap them. A logo version under the same names would have to be replaced during the export. So the committed outputs stay neutral. Until now `make_enclosure.py` picked the logo when `logo_polygons.json` was present; with the file committed, the next regeneration would silently have put the logo into the exported print data. Therefore the logo is now opt-in: `python3 -I make_enclosure.py --logo` writes only `enclosure_logo.json`; the logo build goes to `handrad_enclosure_logo.sc`, `enclosure_logo.step`, `front_shell_logo.stl`, which are git-ignored and on the deny-list (README "Regenerate"). Checked: `enclosure.json` and `assembly_check.json` byte-identical without `--logo`, `enclosure_logo.json` builds with `solidcraft-cli` (4 logo polygons + "PG").
- **Board 3D model:** `generate_board.py` chose the FireBeetle model by the presence of `hardware/vendor/DFR0654.step`. With the folder committed, every `export.sh` run in the private repository would have put the vendor model into `handrad.kicad_pcb` and the renders, which are exported (missing model path there, and renders that show the model, which the licence does not allow publicly). Now `handrad.kicad_pcb` and the renders always use the simplified model; with the vendor folder `generate_board.py` also writes a temporary copy `handrad_pcb/handrad_vendor.kicad_pcb` with DFR0654, `export.sh` exports `fab/handrad.step` from it and deletes it (git-ignored). The committed board and fab outputs are unchanged (KiCad reorders the board file on every run; only `handrad.step` was taken from the run).
- **Regenerated, not copied:** `handrad.step` in the local checkout dated from 2026-11-09 (older board), `handrad_assembly.sc` from 2026-11-10 (older enclosure). Both were regenerated for the current state: `handrad.step` with `export.sh` (board rev 2, contains DFR0654), `handrad_assembly.sc` with `make_assembly.py` (positions unchanged, `handrad_assembly.json` byte-identical). The Makera A-axis STEP was downloaded again (SHA-256 and git blob as in ticket #48). The spoilboard STEP is, apart from CRLF line endings, identical to the file in Makera's repository. Both generators reproduce their committed headers from the committed files (`a_axis_geometry.h`: only the source comment changed).

## 2026-11-11 · Public release: MIT licence, README, export without history (ticket #46, user decision)

- **Question:** Under which licence and in which form is the project published, and what does a reader of the public repository see first?
- **Decision (user):** **MIT** (`LICENSE`, copyright holder Danny Smolinsky), published as a separate public repository with **a fresh history**: a single initial commit of the stripped tree. The vendored three.js keeps its own MIT licence (`web/vendor/three-LICENSE`).
- **README:** `README.md` at the root, in English: what the handwheel is, features, hardware, build and flash, a safety notice (no warranty, the machine can move, not an emergency stop, test carefully), a trademark notice (Makera and Carvera are trademarks of Makera Inc., no affiliation or endorsement, logo not included, spoilboard and rotary-axis dimensions derived from Makera's public CAD files in MakeraInc/CarveraProfiles, CAD files not included) and the third-party components (three.js MIT; KiCad library footprints in the board file and KiCad 3D models in the renders under CC BY-SA 4.0 with the design exception; U8g2, Arduino-ESP32, ESP-IDF and Unity only fetched at build time). Chosen instead of a README per folder only: a public repository needs one entry point that states the risks before anyone flashes.
- **Test data:** IPv4 addresses in tests and in `tools/dump_web_pages.cpp` use the documentation range 192.0.2.0/24 (RFC 5737) instead of private LAN addresses; the example SSID is `Beispiel-WLAN`. `192.168.4.1` stays: it is the ESP32 soft-AP default address of the setup portal, firmware behaviour, not a network address of ours. Test 62 keeps an 11-character host (`192.0.2.105`), because it checks the exact fit of the output buffer.
