danyial/makera-jog-wheel/hardware/enclosure/enclosure_front.png

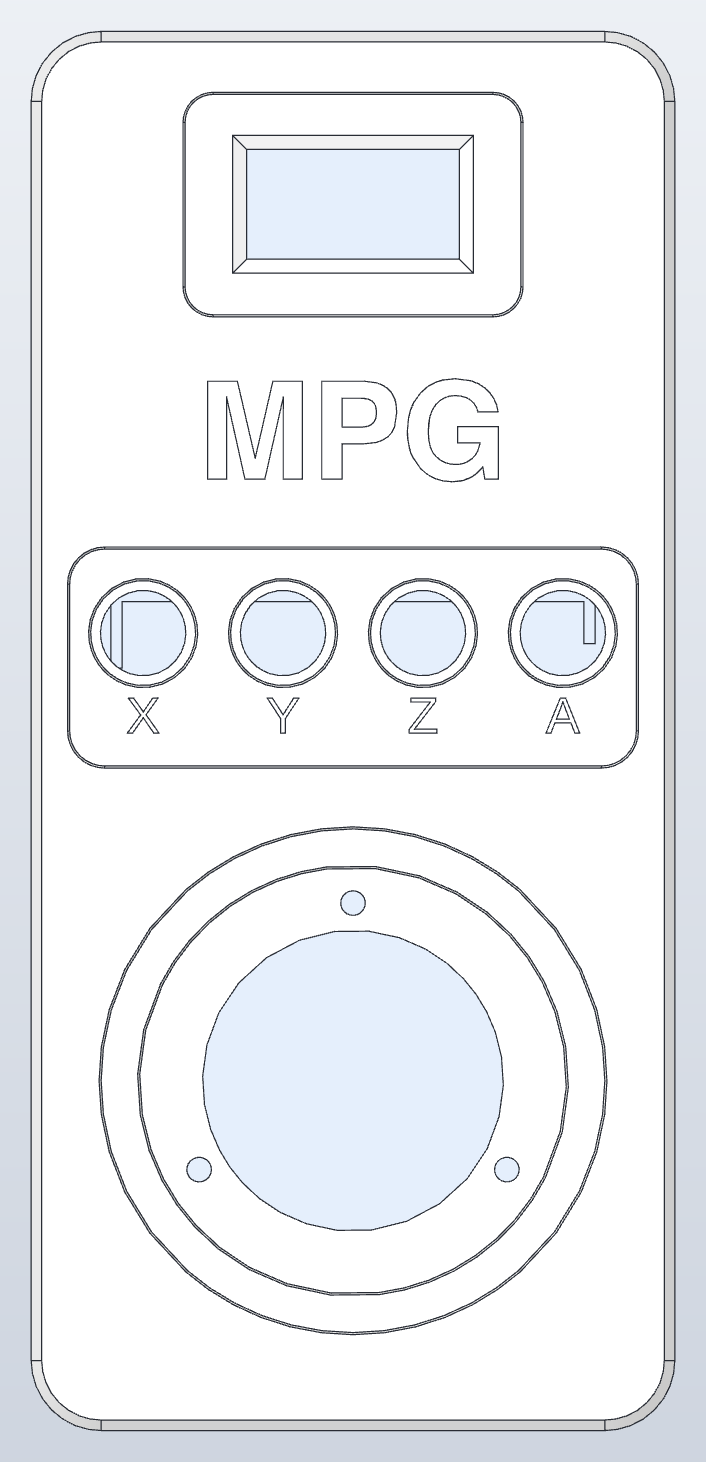
hardware/enclosure/enclosure_front.png
