danyial/makera-jog-wheel/hardware/enclosure/enclosure_inside.png

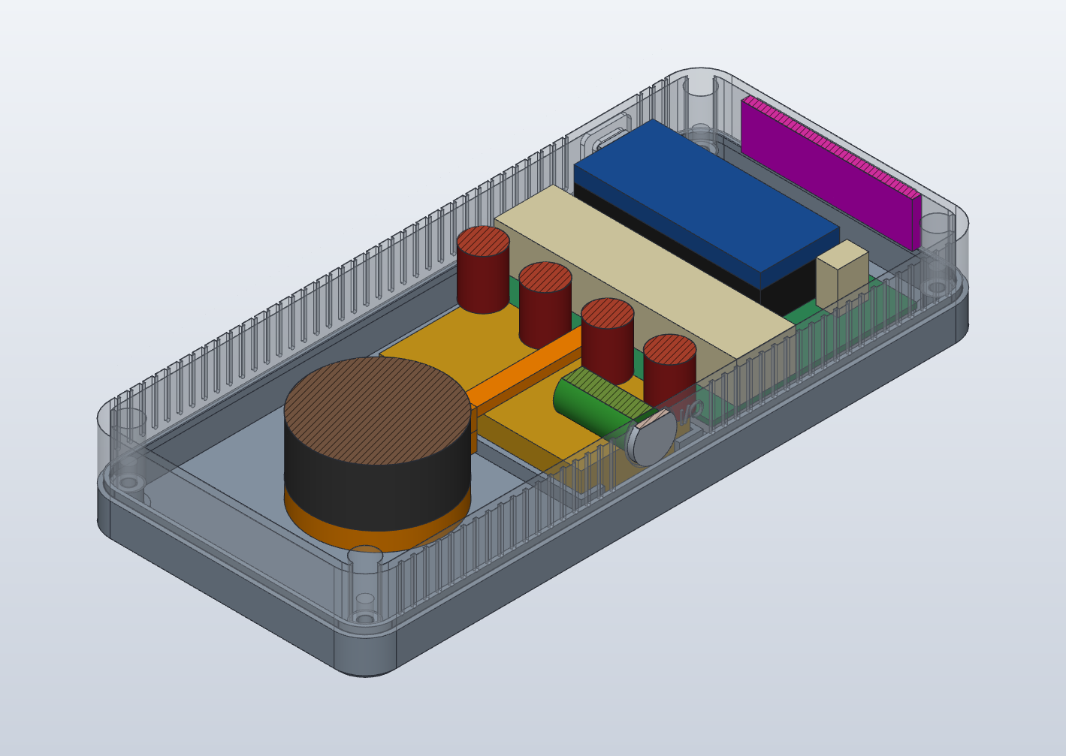
hardware/enclosure/enclosure_inside.png
