danyial/makera-jog-wheel/hardware/enclosure/enclosure_side_left.png

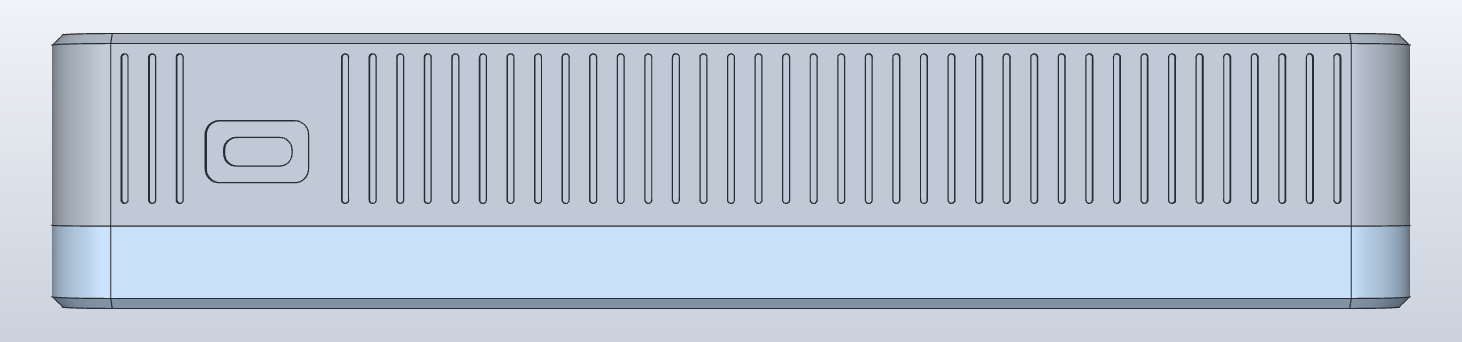
hardware/enclosure/enclosure_side_left.png
