danyial/makera-jog-wheel/hardware/enclosure/enclosure_side_right.png

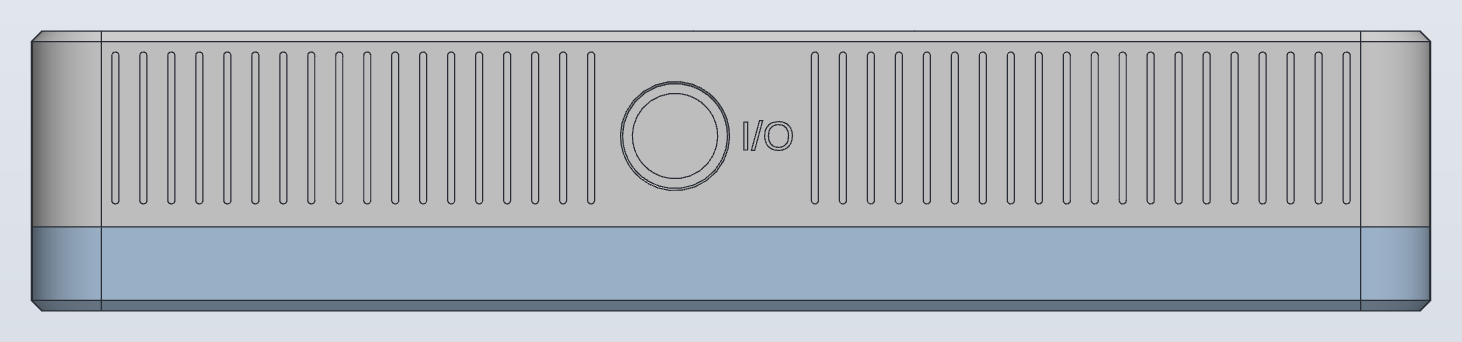
hardware/enclosure/enclosure_side_right.png
