danyial/makera-jog-wheel/hardware/handrad_pcb/fab/handrad-3d-bottom.png

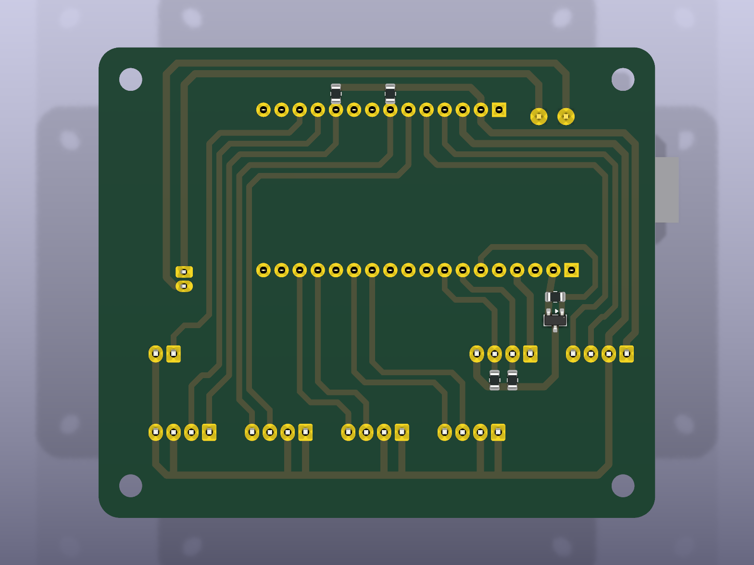
hardware/handrad_pcb/fab/handrad-3d-bottom.png
