danyial/makera-jog-wheel/hardware/handrad_pcb/fab/handrad-top.png

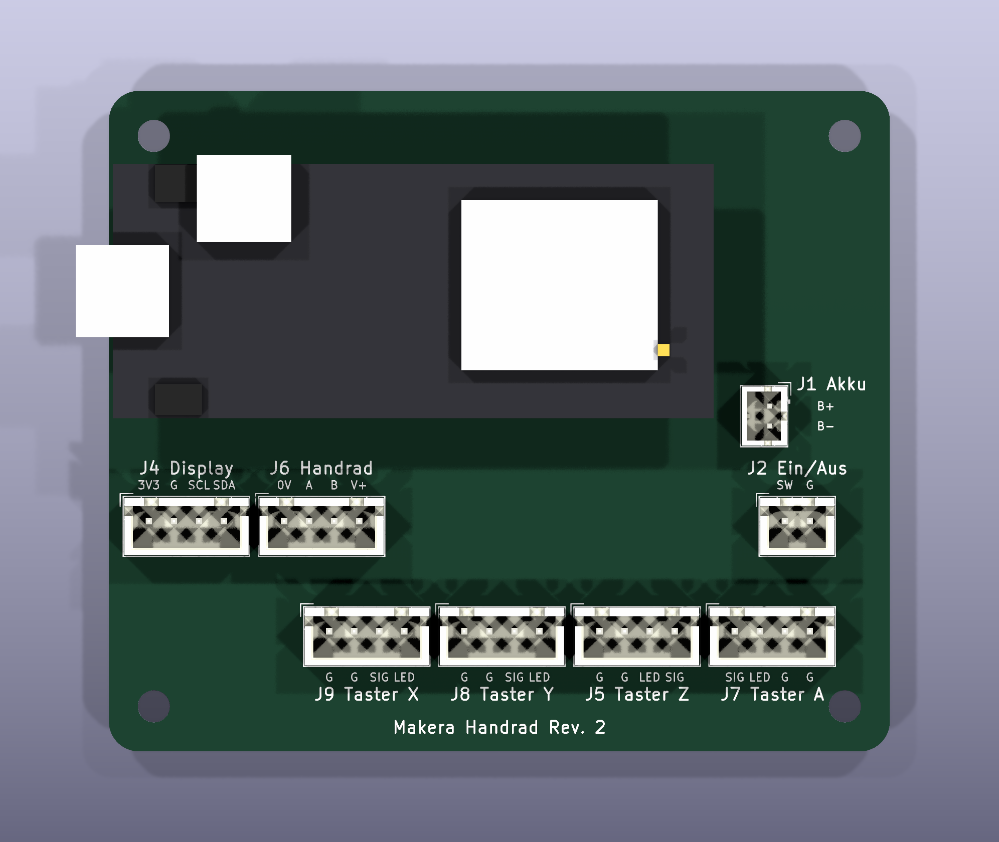
hardware/handrad_pcb/fab/handrad-top.png
