danyial/makera-jog-wheel/hardware/enclosure/bottom_tray.stl

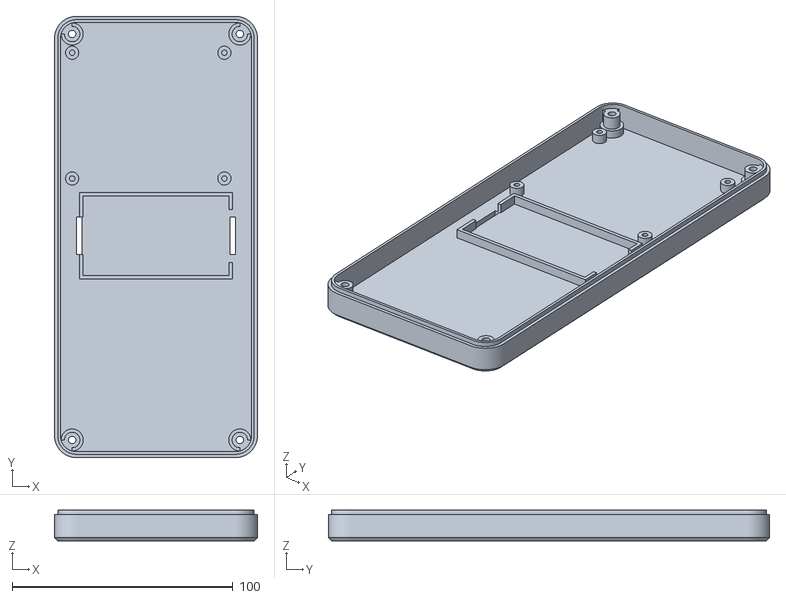
[picture p10: CAD file, 2026-11-11]
hardware/enclosure/bottom_tray.stl
92.0 x 200.0 x 14.0
