danyial/makera-jog-wheel/hardware/models/firebeetle2_esp32ue.step

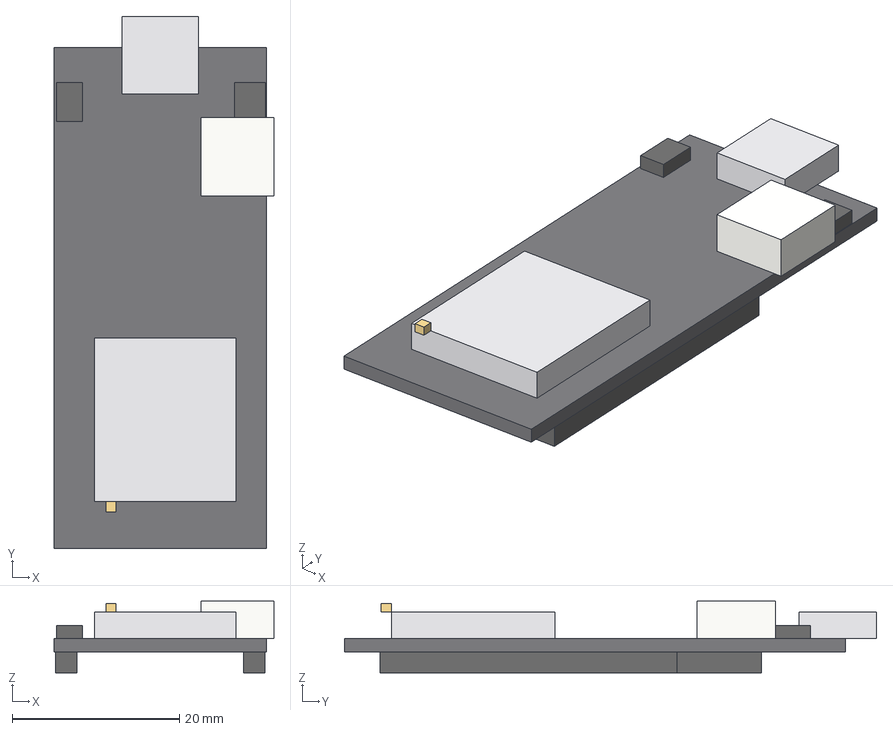
[picture p11: CAD file, 2026-11-11]
hardware/models/firebeetle2_esp32ue.step
26.3 x 63.7 x 8.60 mm
