danyial/makera-jog-wheel/hardware/enclosure/front_shell.stl

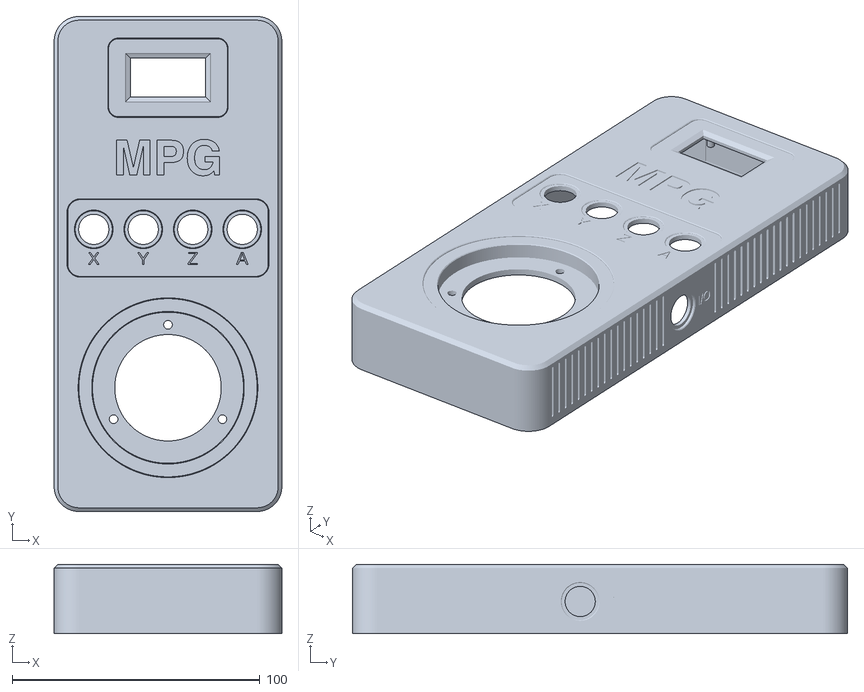
[picture p12: CAD file, 2026-11-11]
hardware/enclosure/front_shell.stl
92.0 x 200.0 x 28.0
