danyial/makera-jog-wheel/hardware/models/pogo_p50_j1.step

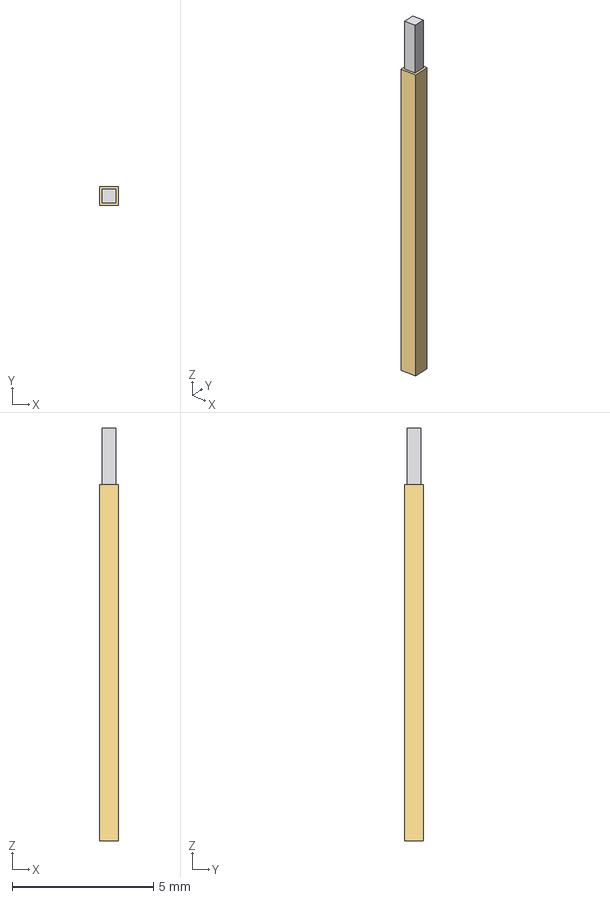
[picture p13: CAD file, 2026-11-11]
hardware/models/pogo_p50_j1.step
0.68 x 0.68 x 14.6 mm
