danyial/makera-jog-wheel/hardware/enclosure/enclosure.step

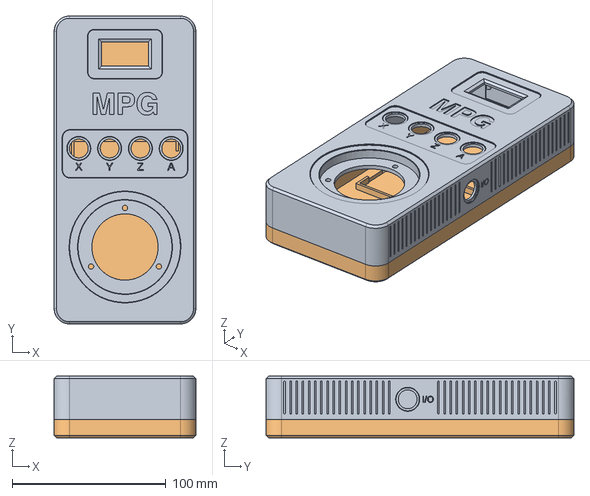
[picture p14: CAD file, 2026-11-11]
hardware/enclosure/enclosure.step
92.0 x 200.0 x 40.0 mm
