danyial/makera-jog-wheel/hardware/handrad_pcb/fab/handrad-1to1.pdf

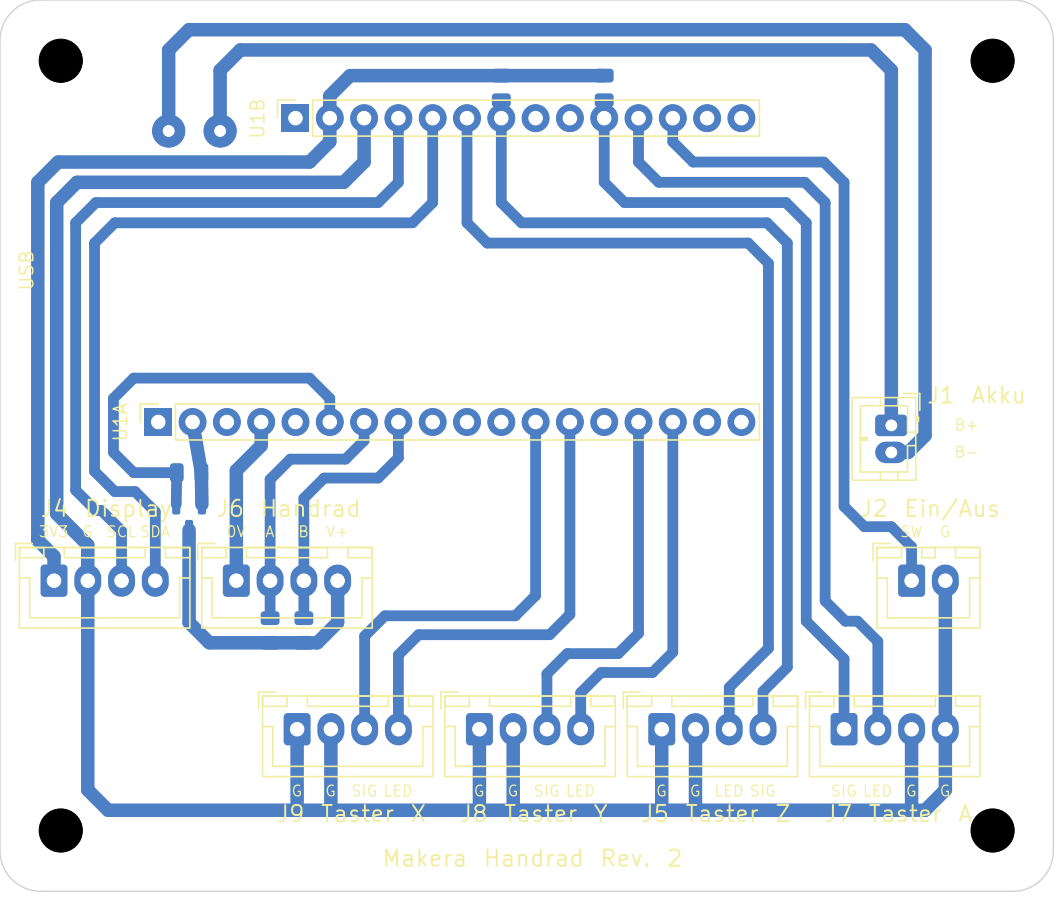
[picture p15: page 1]

J9 Taster X Makera Handrad Rev. 2
