danyial/makera-jog-wheel/hardware/handrad_pcb/handrad.kicad_pcb

## KiCad design hardware/handrad_pcb/handrad.kicad_pcb (2026-11-11)

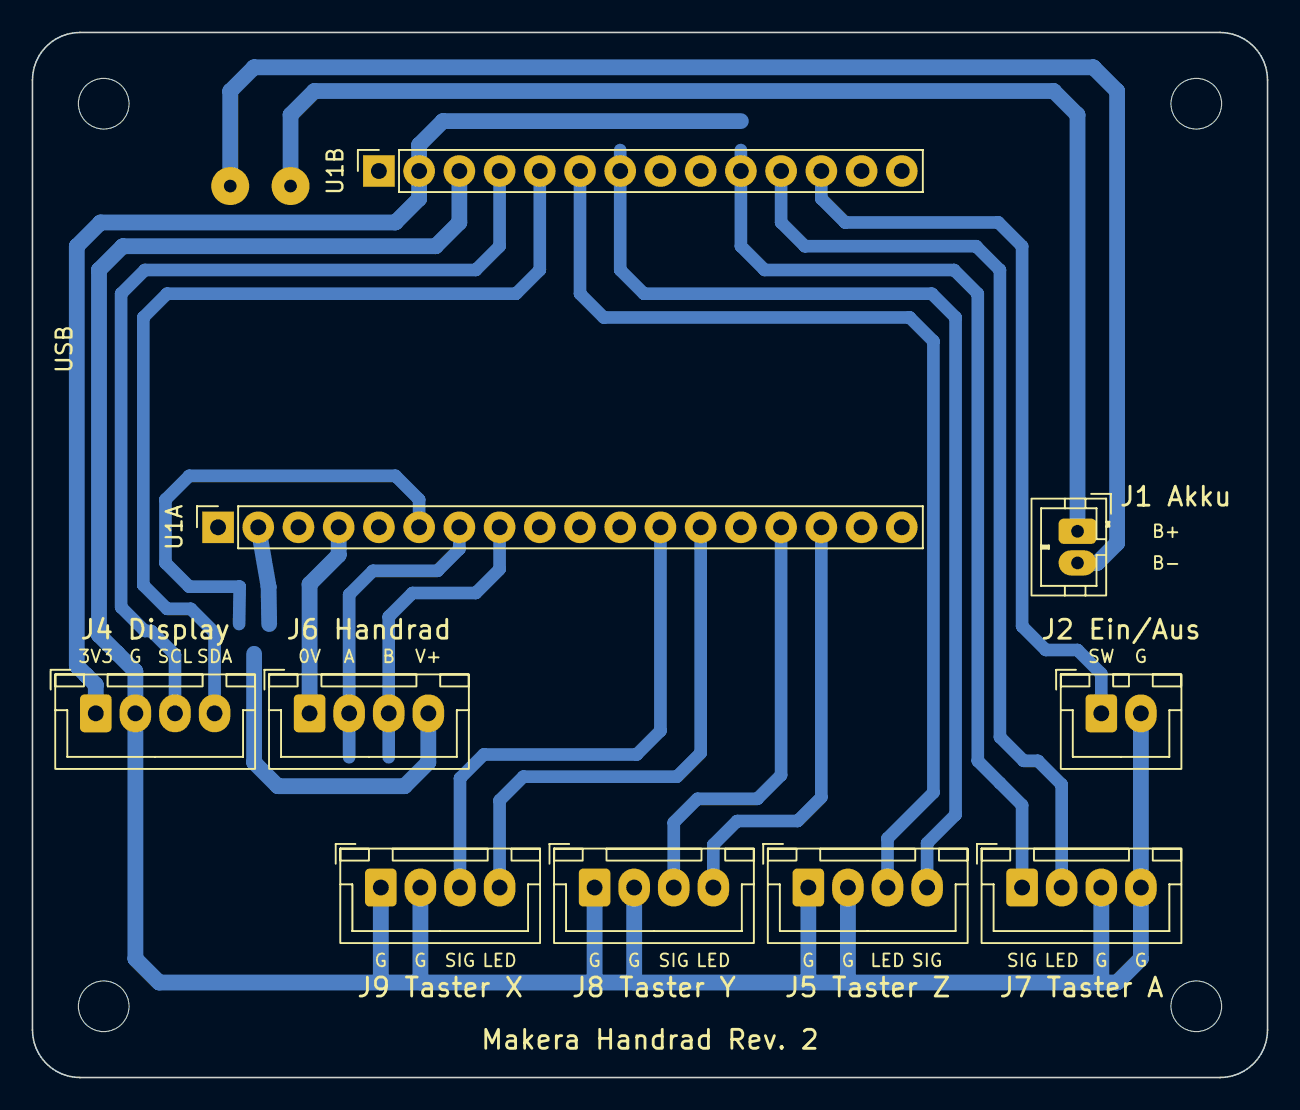
[picture p16: board handrad.kicad_pcb from above]

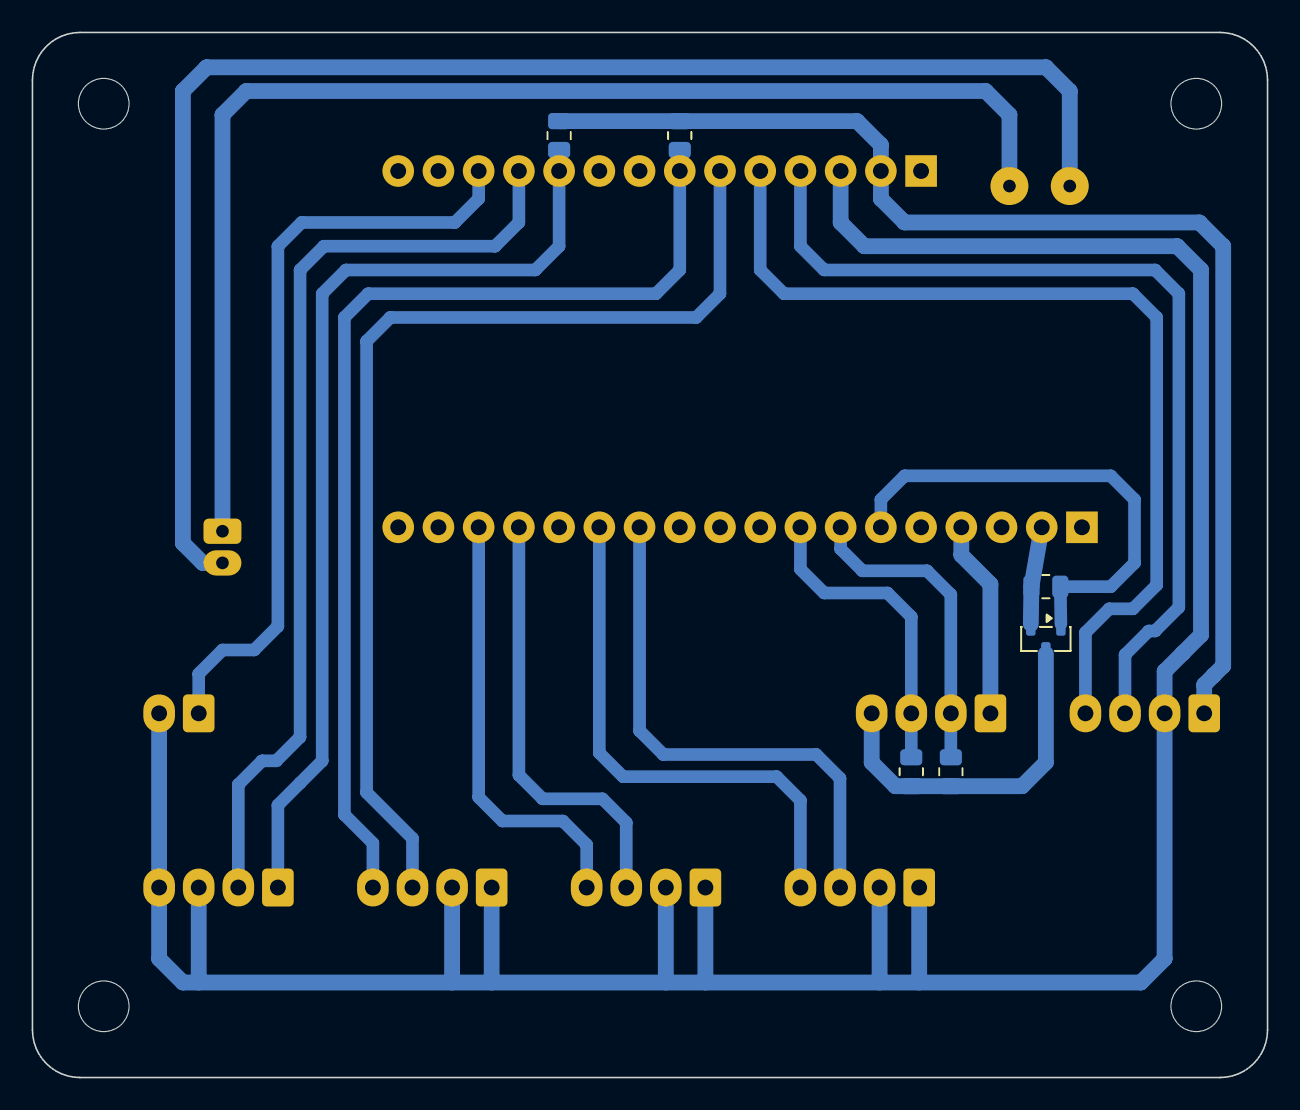
[picture p17: board handrad.kicad_pcb from below]

Board: 2 copper layers, 78.0 x 66.0 mm, 23 parts (6 on the bottom side), 21 nets.

Parts:
H1, H2, H3, H4: MountingHole_3.2mm_M3
J1: Akku PH2.0; JST_PH_B2B-PH-K_1x02_P2.00mm_Vertical
J2: Ein/Aus; JST_XH_B2B-XH-A_1x02_P2.50mm_Vertical
J4: Display; JST_XH_B4B-XH-A_1x04_P2.50mm_Vertical
J5: Taster Z; JST_XH_B4B-XH-A_1x04_P2.50mm_Vertical
J6: Handrad; JST_XH_B4B-XH-A_1x04_P2.50mm_Vertical
J7: Taster A; JST_XH_B4B-XH-A_1x04_P2.50mm_Vertical
J8: Taster Y; JST_XH_B4B-XH-A_1x04_P2.50mm_Vertical
J9: Taster X; JST_XH_B4B-XH-A_1x04_P2.50mm_Vertical
P1: Pogo BAT-
P2: Pogo BAT+
Q1: AO3401; SOT-23
R1, R2, R4, R5: 10k; R_0805_2012Metric
R6: 100k; R_0805_2012Metric
U1: FireBeetle 2 ESP32-UE
U1A: FireBeetle unten; PinSocket_1x18_P2.54mm_Vertical
U1B: FireBeetle oben; PinSocket_1x14_P2.54mm_Vertical

Connections:
+3V3: J4.1, R4.2, R5.2, U1B.2
+3V3_ENC: Q1.2, R6.1, U1A.2
BAT+: J1.1, P2.1
BAT-: J1.2, P1.1
BTN_A: J7.1, R5.1, U1B.10
BTN_X: J9.3, U1A.12
BTN_Y: J8.3, U1A.15
BTN_Z: J5.4, R4.1, U1B.7
ENC_A: J6.2, R1.2, U1A.7
ENC_B: J6.3, R2.2, U1A.8
ENC_PWR: Q1.1, R6.2, U1A.6
ENC_VCC: J6.4, Q1.3, R1.1, R2.1
GND: J2.2, J4.2, J5.1, J5.2, J7.3, J7.4, J8.1, J8.2, J9.1, J9.2, U1B.3
GND_ENC: J6.1, U1A.4
LED_A: J7.2, U1B.11
LED_X: J9.4, U1A.13
LED_Y: J8.4, U1A.16
LED_Z: J5.3, U1B.6
PWR_SW: J2.1, U1B.12
SCL: J4.3, U1B.4
SDA: J4.4, U1B.5
