danyial/makera-jog-wheel/src/logo_fallback.h

#pragma once
// Neutral screensaver picture "MPG" (manual pulse generator) as 1-bit XBM for U8g2::drawXBMP
// (SPEC 10.4, ticket #45). Own pixel drawing, no trademark. Used when the private (not exported)
// src/logo_bitmap.h is missing; same names and size (40 x 32) as that file.
#include <cstdint>

#include <pgmspace.h>

constexpr int LOGO_W = 40;
constexpr int LOGO_H = 32;

// Picture (# = lit):
//   ###......###..#########........######...
//   ####....####..##########.....##########.
//   ####....####..###########...############
//   #####..#####..###.....####..####....####
//   #####..#####..###......###..###......###
//   ###.####.###..###......###..###.........
//   ###.####.###..###......###..###.........
//   ###..##..###..###......###..###.........
//   ###..##..###..###......###..###.........
//   ###......###..###......###..###.........
//   ###......###..###......###..###.........
//   ###......###..###......###..###.........
//   ###......###..###......###..###.........
//   ###......###..###.....####..###.........
//   ###......###..###########...###.........
//   ###......###..##########....###...######
//   ###......###..#########.....###...######
//   ###......###..###...........###...######
//   ###......###..###...........###......###
//   ###......###..###...........###......###
//   ###......###..###...........###......###
//   ###......###..###...........###......###
//   ###......###..###...........###......###
//   ###......###..###...........###......###
//   ###......###..###...........###......###
//   ###......###..###...........###......###
//   ###......###..###...........###......###
//   ###......###..###...........###......###
//   ###......###..###...........####....####
//   ###......###..###...........############
//   ###......###..###............##########.
//   ###......###..###..............######...
static const uint8_t LOGO_XBM[160] PROGMEM = {
    0x07, 0xce, 0x7f, 0x80, 0x1f, 0x0f, 0xcf, 0xff, 0xe0, 0x7f, 0x0f, 0xcf,
    0xff, 0xf1, 0xff, 0x9f, 0xcf, 0xc1, 0xf3, 0xf0, 0x9f, 0xcf, 0x81, 0x73,
    0xe0, 0xf7, 0xce, 0x81, 0x73, 0x00, 0xf7, 0xce, 0x81, 0x73, 0x00, 0x67,
    0xce, 0x81, 0x73, 0x00, 0x67, 0xce, 0x81, 0x73, 0x00, 0x07, 0xce, 0x81,
    0x73, 0x00, 0x07, 0xce, 0x81, 0x73, 0x00, 0x07, 0xce, 0x81, 0x73, 0x00,
    0x07, 0xce, 0x81, 0x73, 0x00, 0x07, 0xce, 0xc1, 0x73, 0x00, 0x07, 0xce,
    0xff, 0x71, 0x00, 0x07, 0xce, 0xff, 0x70, 0xfc, 0x07, 0xce, 0x7f, 0x70,
    0xfc, 0x07, 0xce, 0x01, 0x70, 0xfc, 0x07, 0xce, 0x01, 0x70, 0xe0, 0x07,
    0xce, 0x01, 0x70, 0xe0, 0x07, 0xce, 0x01, 0x70, 0xe0, 0x07, 0xce, 0x01,
    0x70, 0xe0, 0x07, 0xce, 0x01, 0x70, 0xe0, 0x07, 0xce, 0x01, 0x70, 0xe0,
    0x07, 0xce, 0x01, 0x70, 0xe0, 0x07, 0xce, 0x01, 0x70, 0xe0, 0x07, 0xce,
    0x01, 0x70, 0xe0, 0x07, 0xce, 0x01, 0x70, 0xe0, 0x07, 0xce, 0x01, 0xf0,
    0xf0, 0x07, 0xce, 0x01, 0xf0, 0xff, 0x07, 0xce, 0x01, 0xe0, 0x7f, 0x07,
    0xce, 0x01, 0x80, 0x1f,
};
